Acliad/toast-o-meter/Board Files/Renders/Breadboard_DMM.png

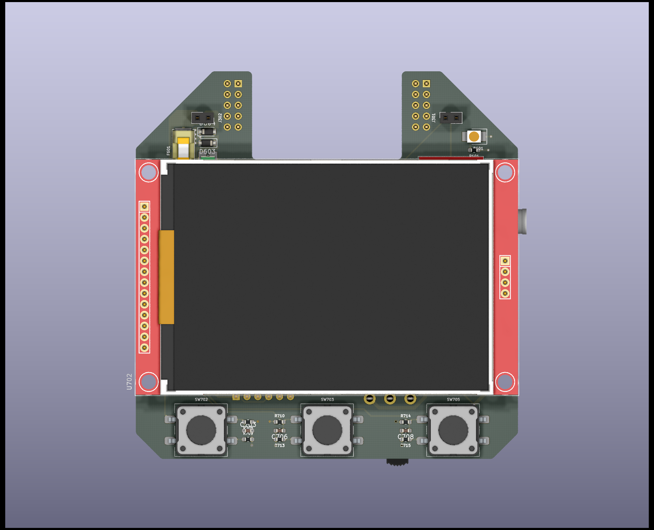
Board Files/Renders/Breadboard_DMM.png
