Acliad/toast-o-meter/Board Files/Graphics/Amps.png

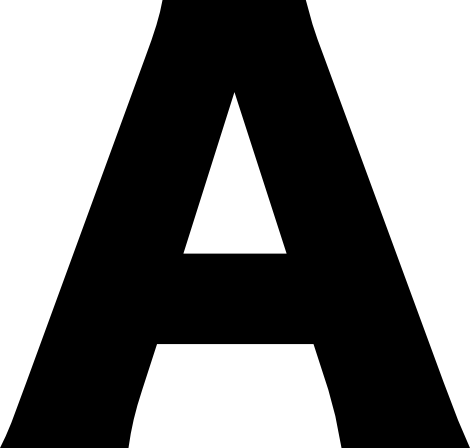
Board Files/Graphics/Amps.png
