Acliad/toast-o-meter/Board Files/Graphics/input_volts.png

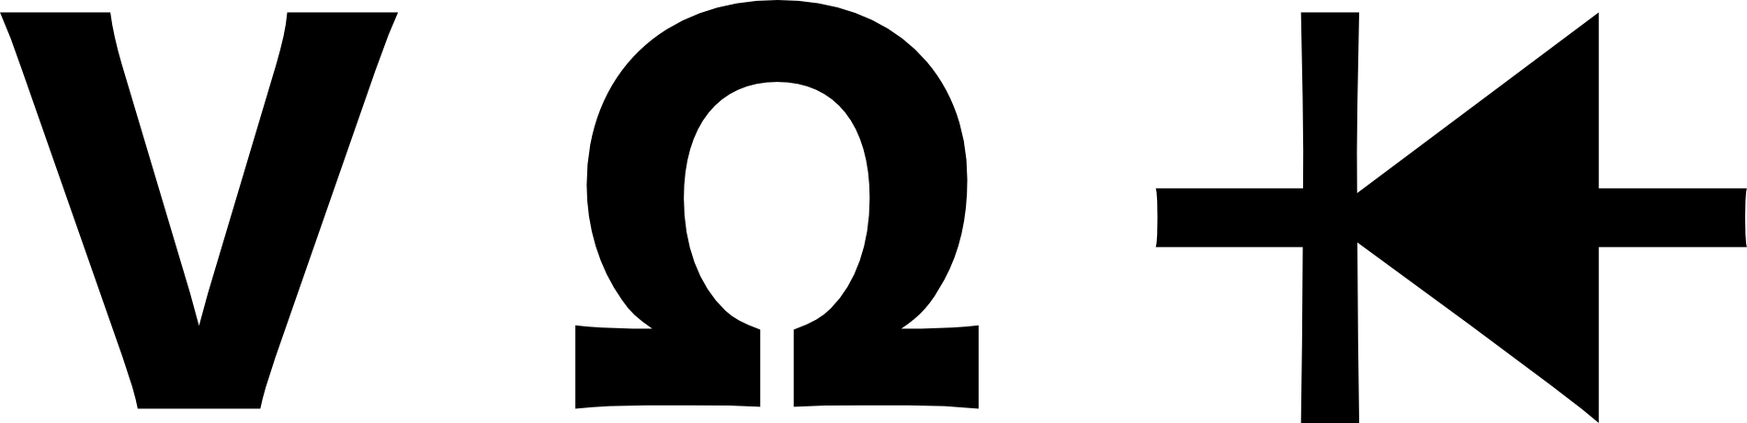
Board Files/Graphics/input_volts.png
