Acliad/toast-o-meter/Board Files/Graphics/ohms.png

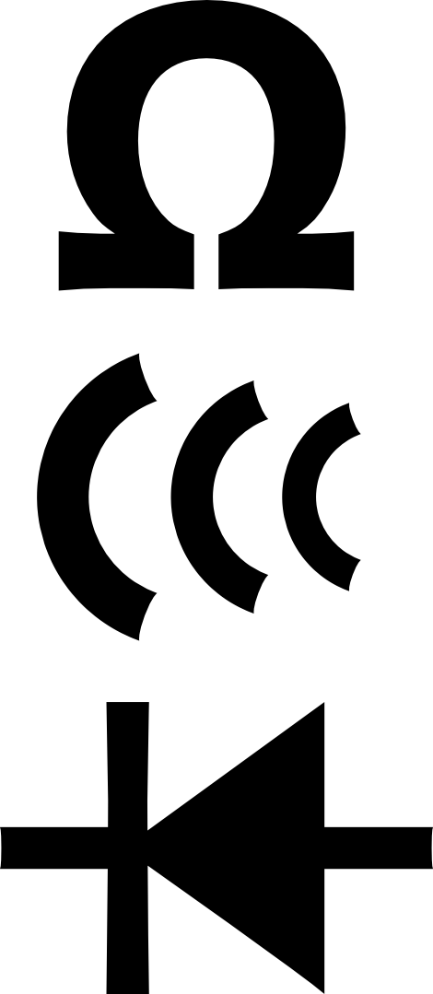
Board Files/Graphics/ohms.png
