Acliad/toast-o-meter/Board Files/Graphics/volts.png

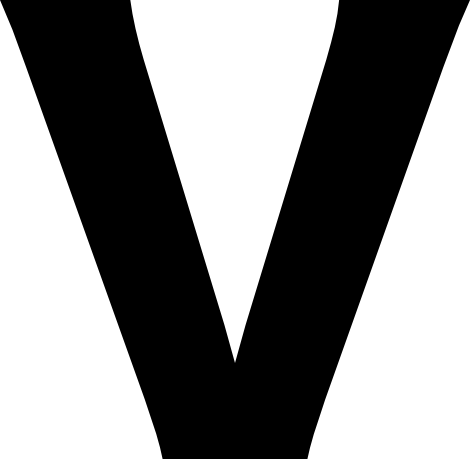
Board Files/Graphics/volts.png
