Acliad/toast-o-meter/Board Files/outline.dxf

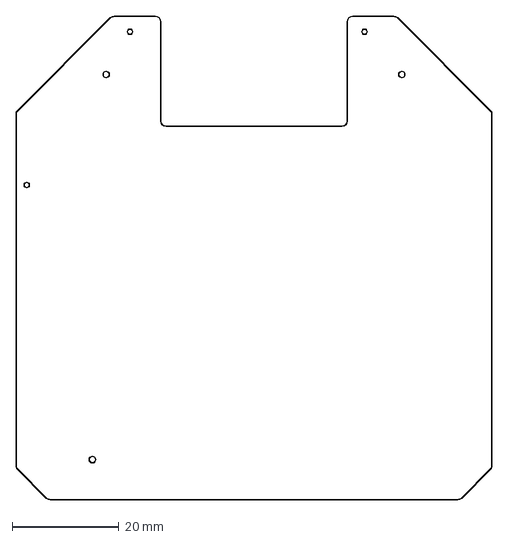
[picture p6: CAD file, 2020-11-14]
Board Files/outline.dxf
89.3 x 90.7 mm
