Acliad/toast-o-meter/Board Files/PDFs/Breadboard_DMM.pdf

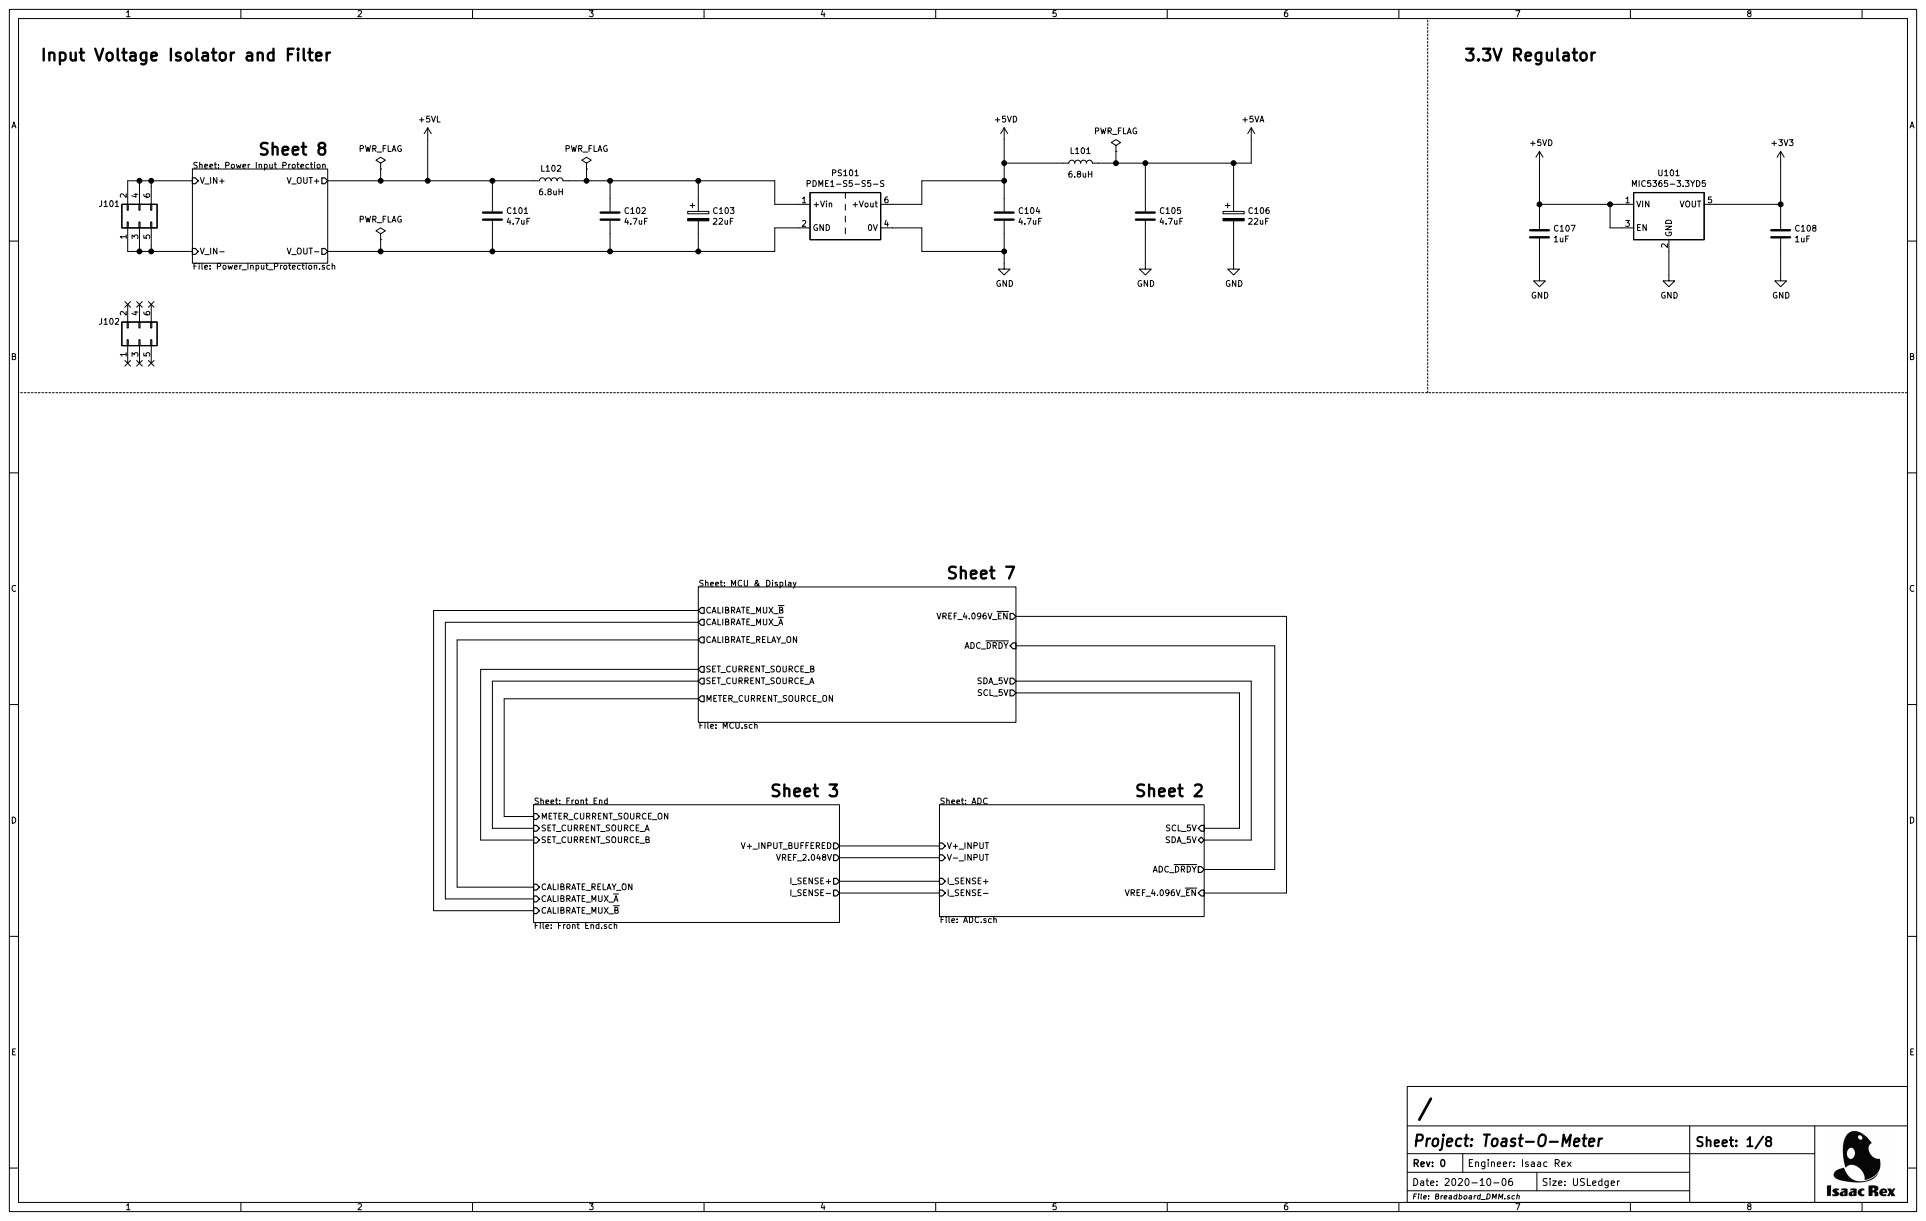
[picture p7: page 1]

Sheet: Power Input Protection

Sheet: MCU & Display File: MCU.sch CALIBRATE_RELAY_ON METER_CURRENT_SOURCE_ON

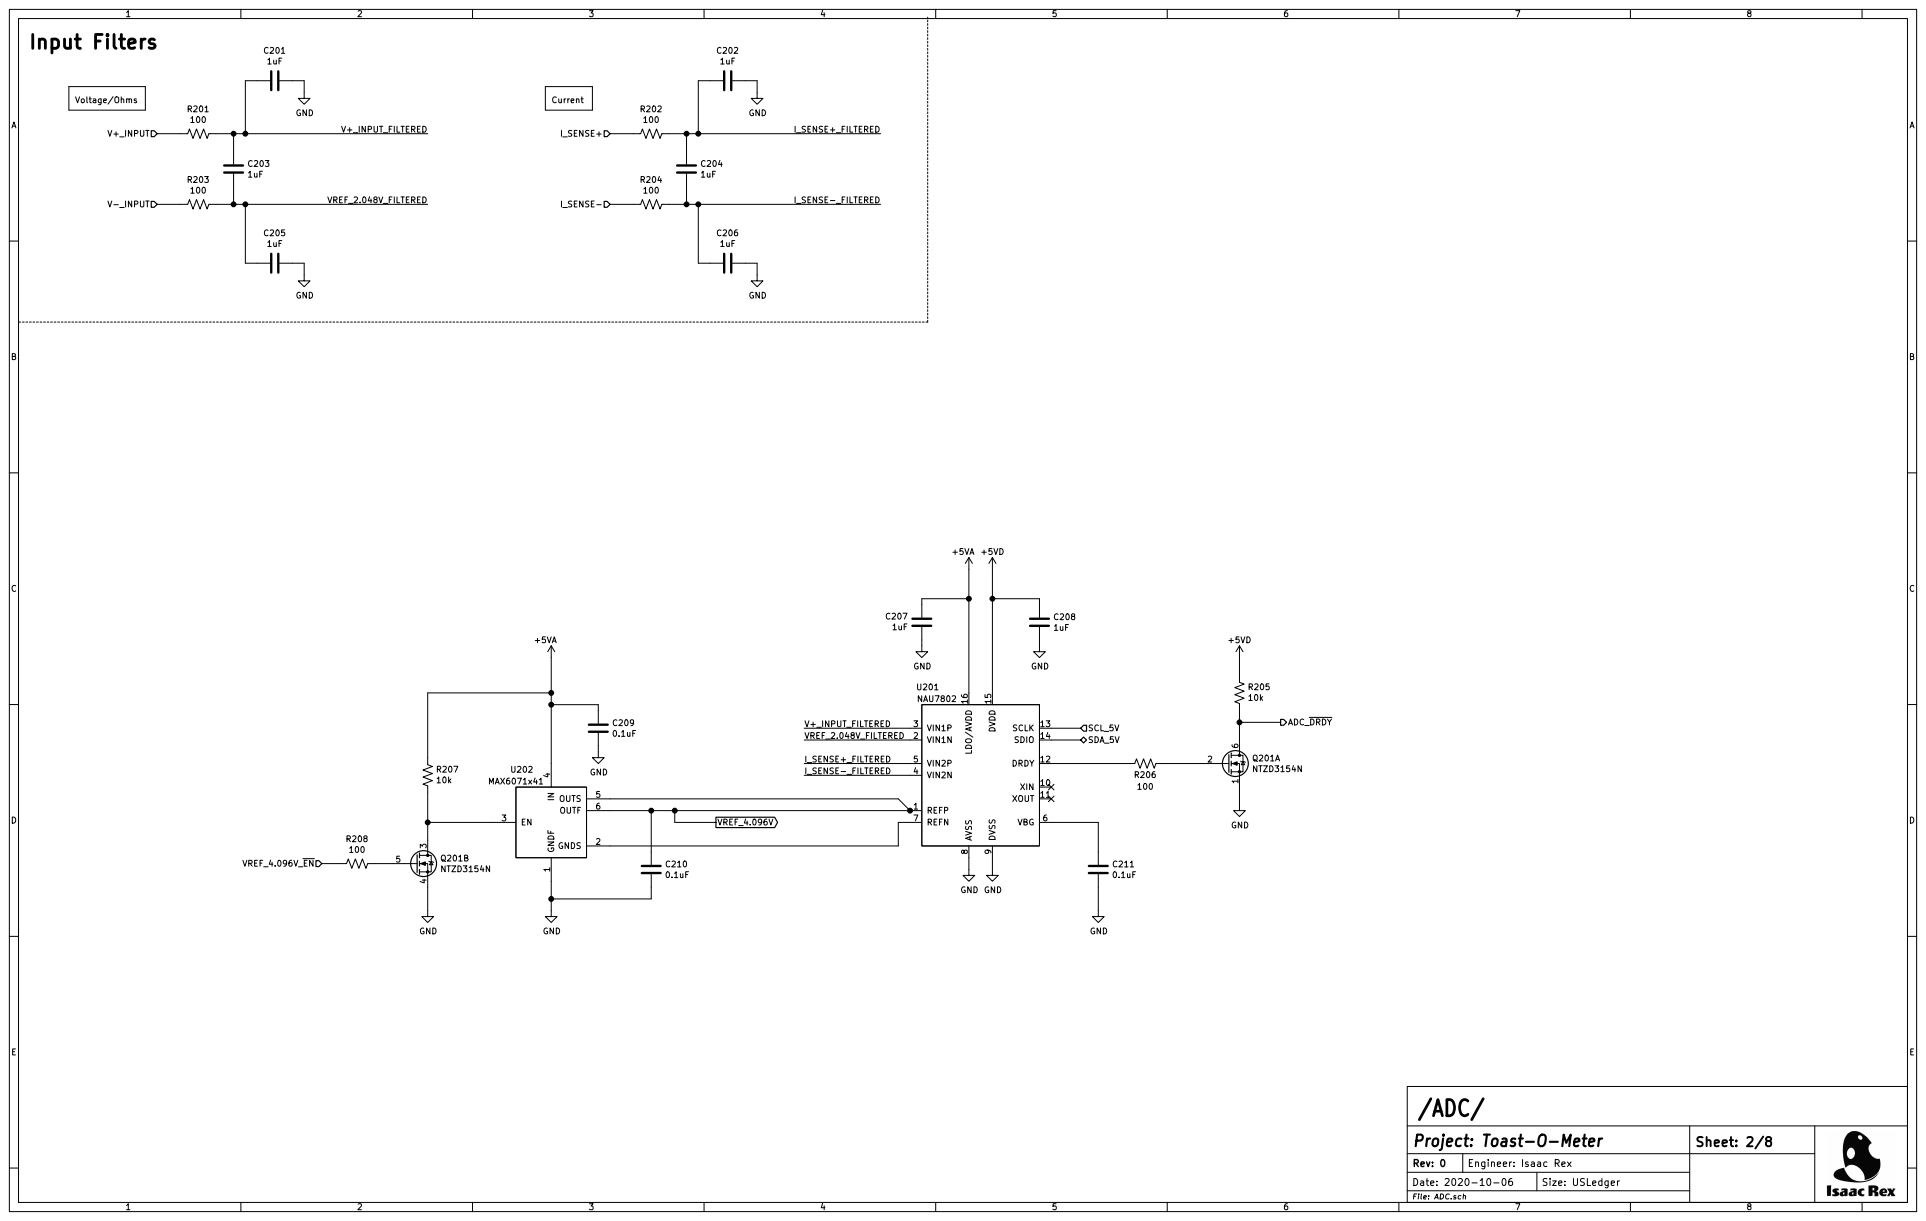
[picture p8: page 2]

File: ADC.sch /ADC/

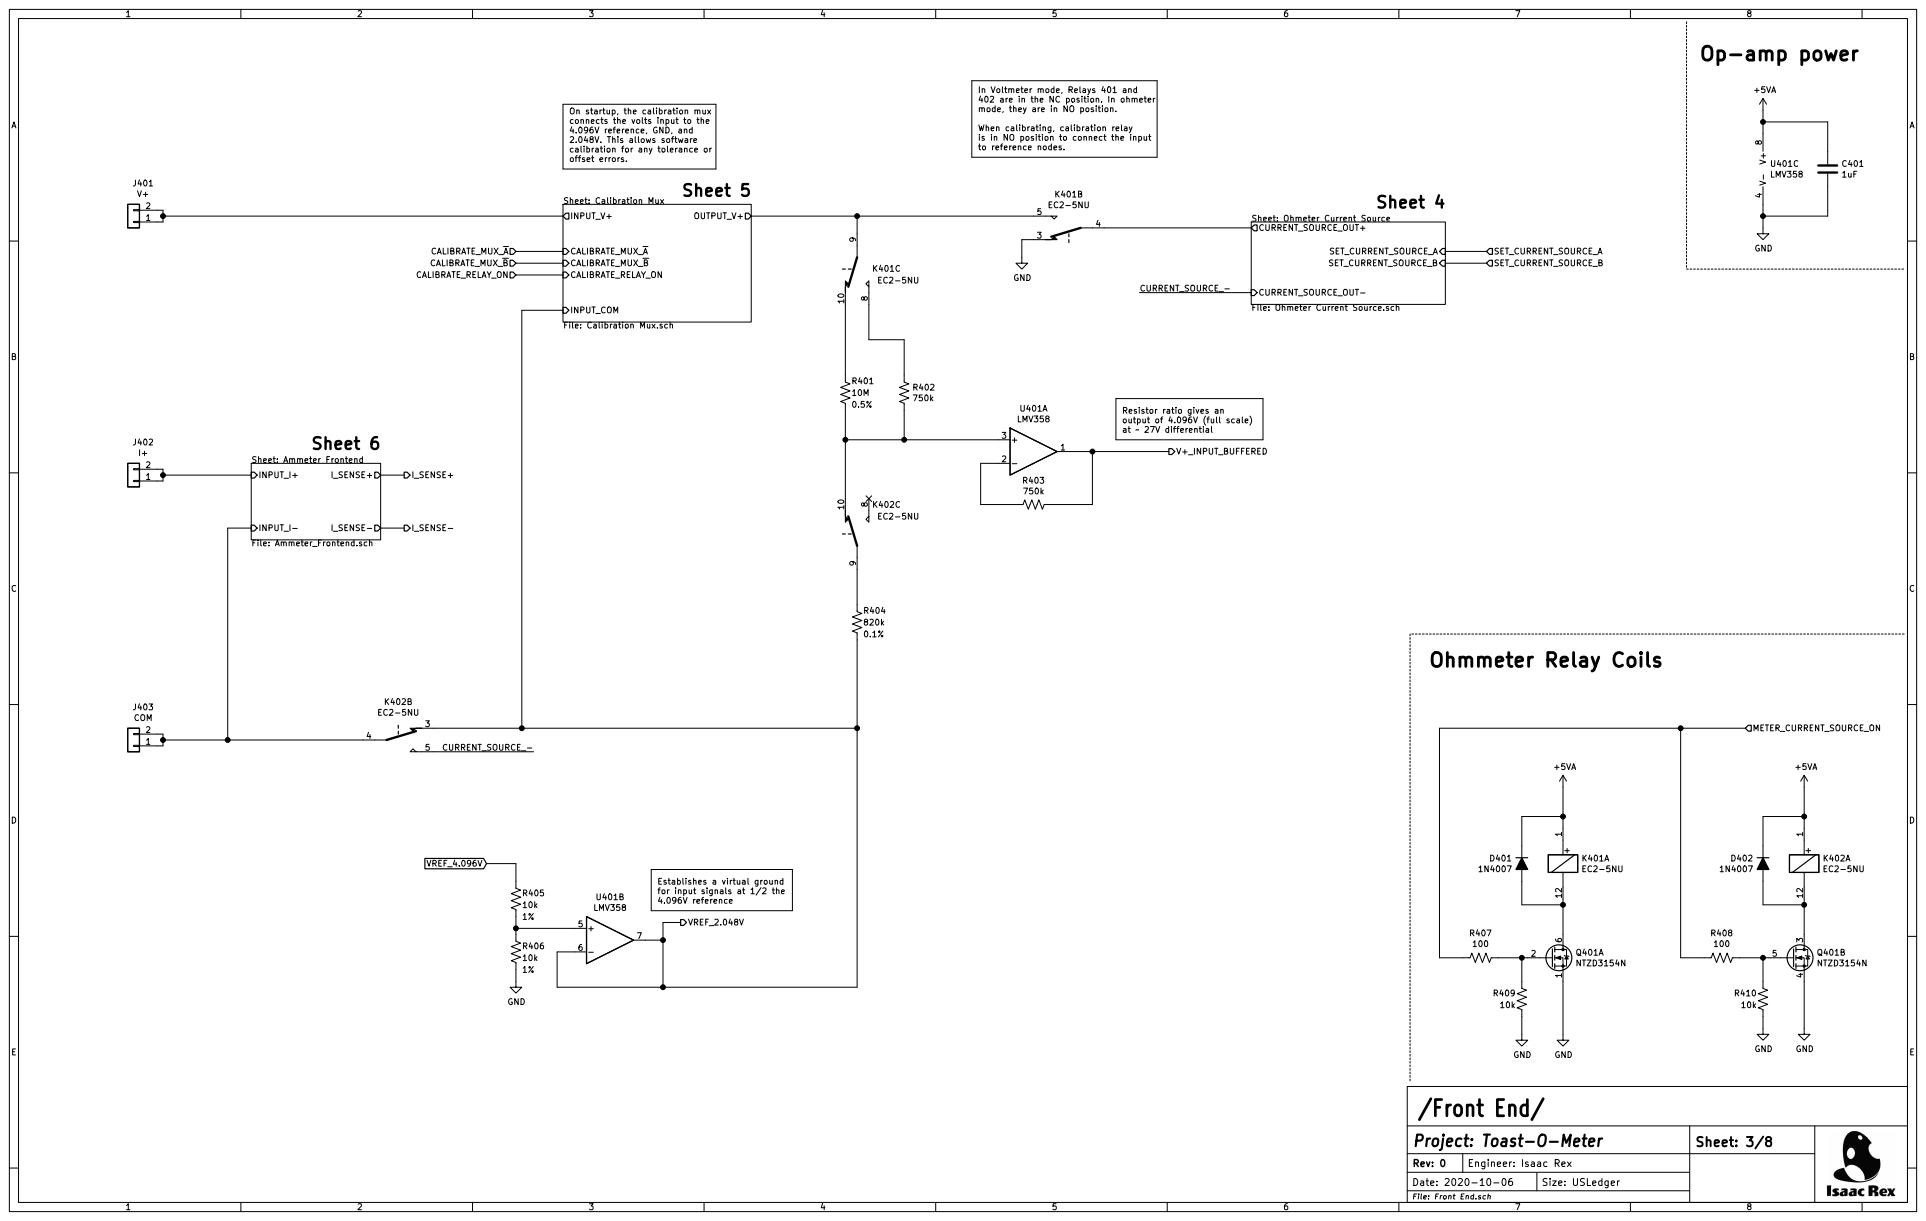
[picture p9: page 3]

In Voltmeter mode, Relays 401 and
402 are in the NC position. In ohmeter
mode, they are in NO position.

On startup, the calibration mux
connects the volts input to the
4.096V reference, GND, and 2.048V. This allows software calibration for any tolerance or offset errors.

When calibrating, calibration relay
is in NO position to connect the input

Sheet: Calibration Mux File: Calibration Mux.sch

SET_CURRENT_SOURCE_B CURRENT_SOURCE_OUT+ CURRENT_SOURCE_OUT- Sheet: Ammeter Frontend File: Ammeter_Frontend.sch

Resistor ratio gives an

File: Front End.sch /Front End/

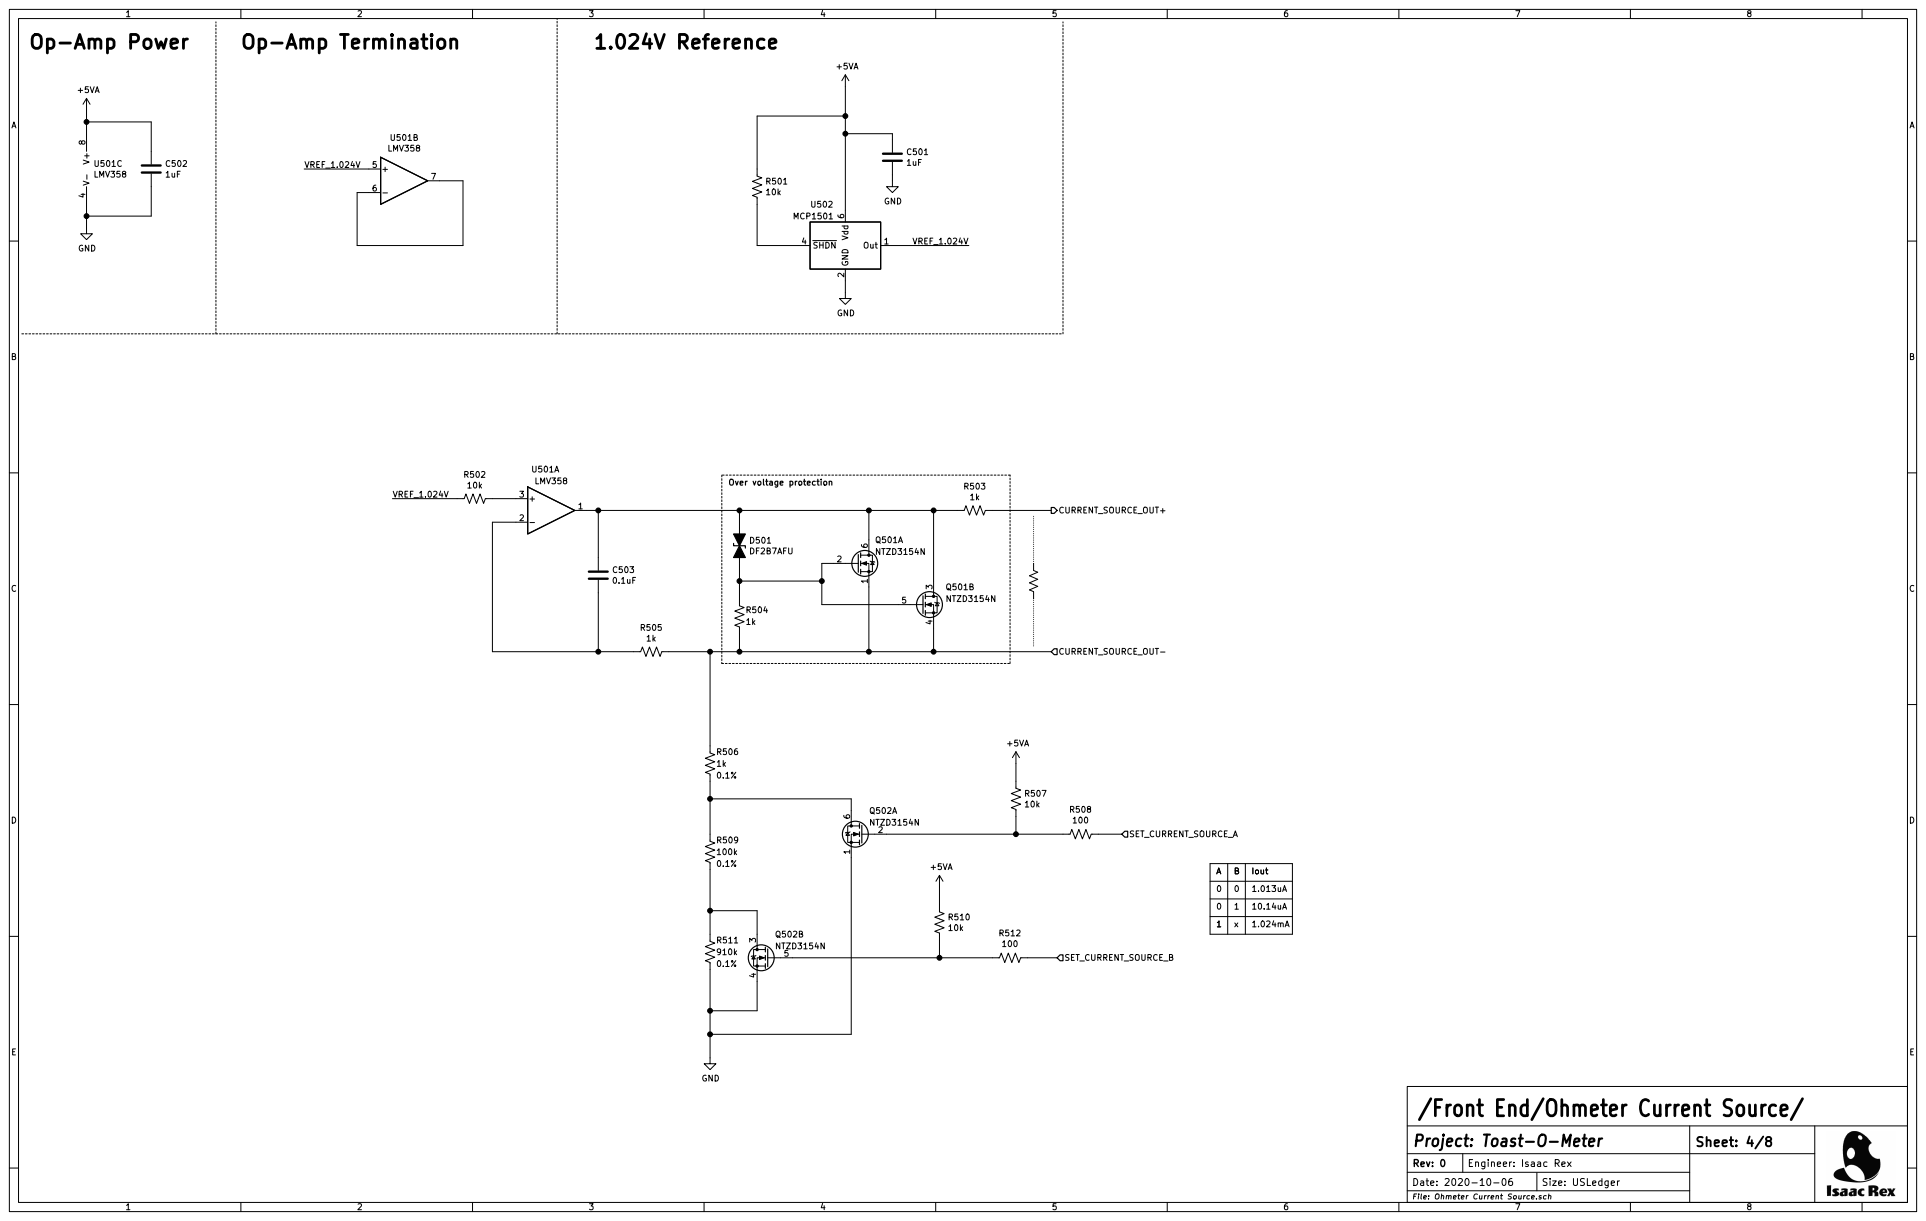
[picture p10: page 4]

1A | B 0 xB | Iout 0 Iout 1.013uA

File: Ohmeter Current Source.sch /Front End/Ohmeter Current Source/

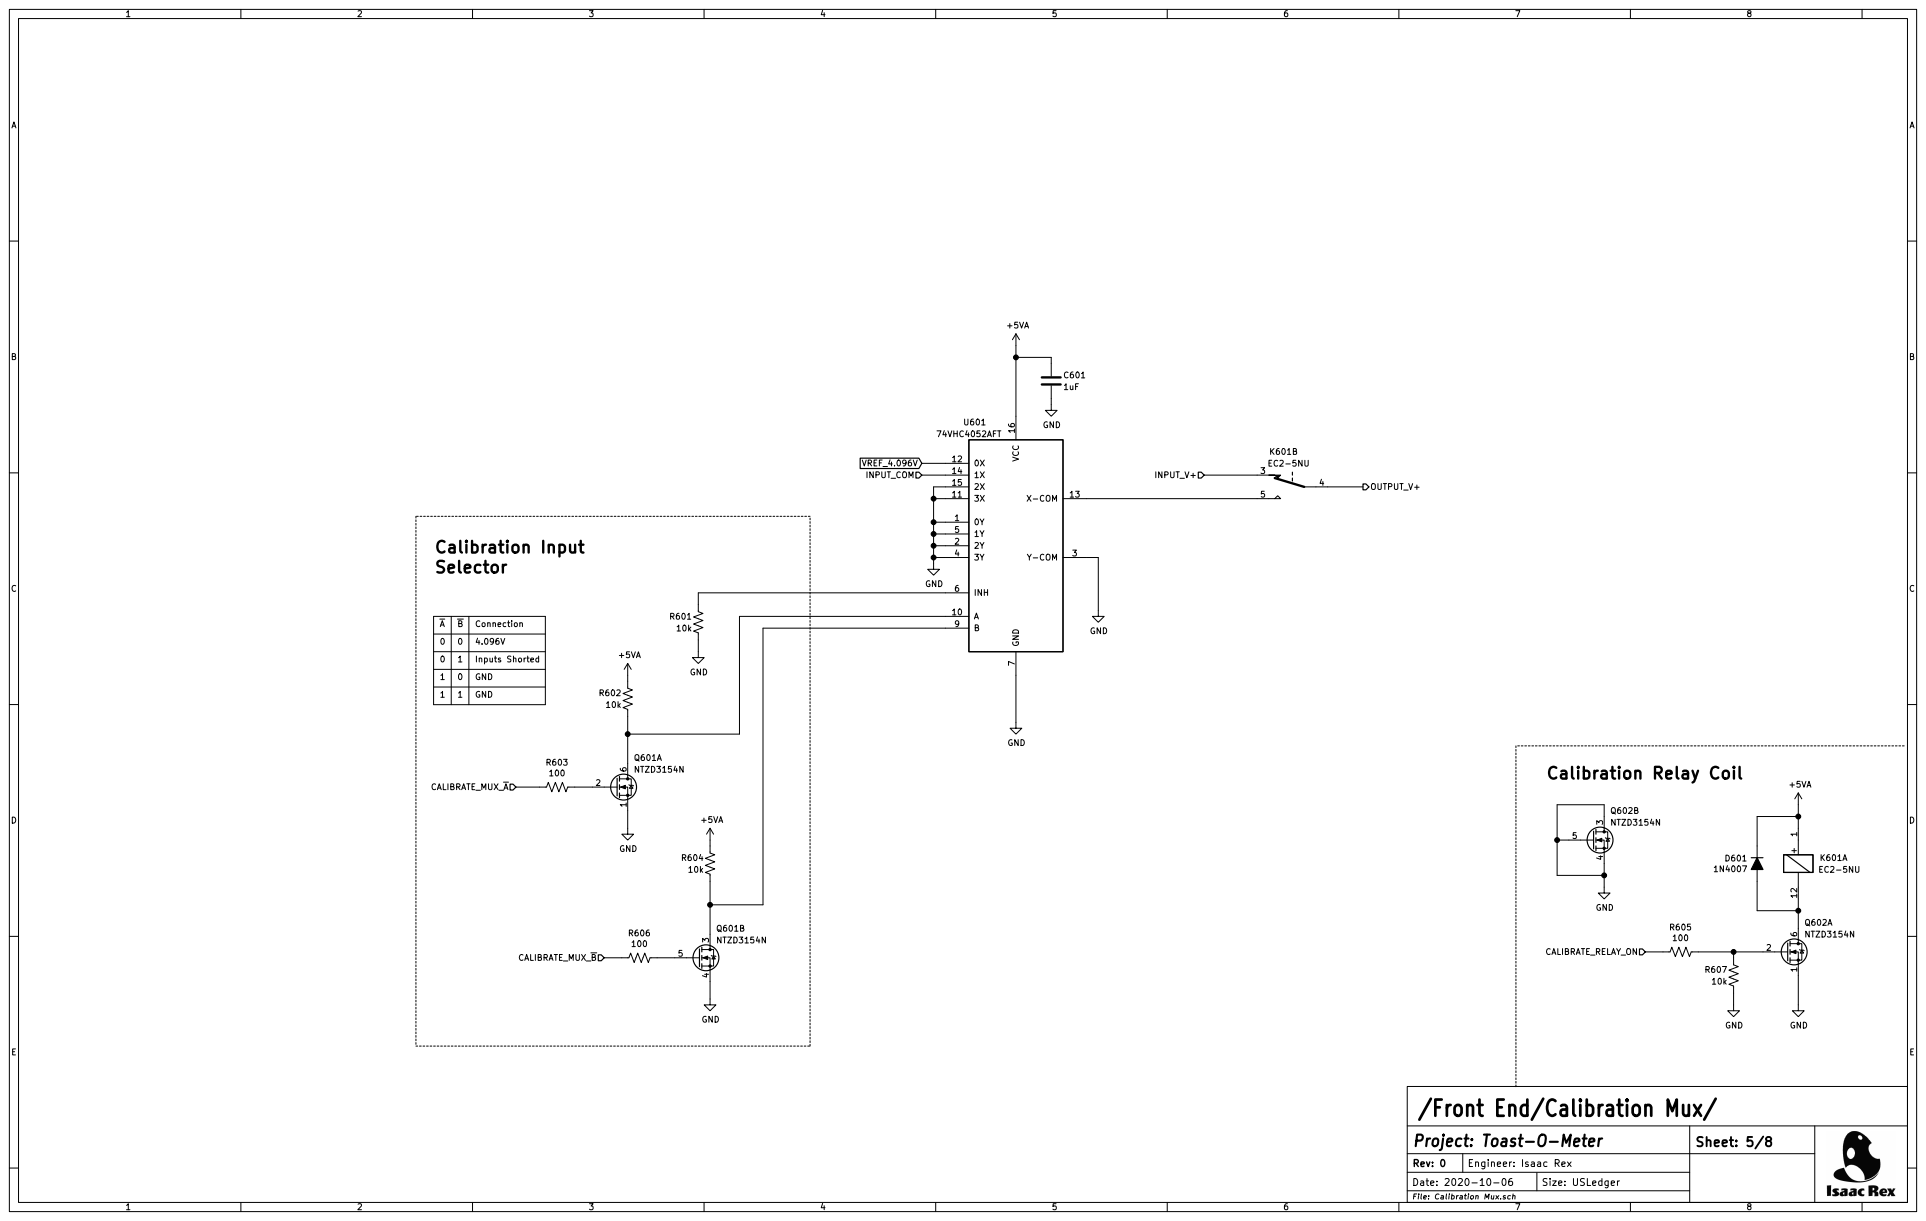
[picture p11: page 5]

0 A B 0 | 4.096V
0 0 | 1 | GND Inputs Shorted

1 | 1 | GND

Engineer: Isaac Rex GND

File: Calibration Mux.sch /Front End/Calibration Mux/

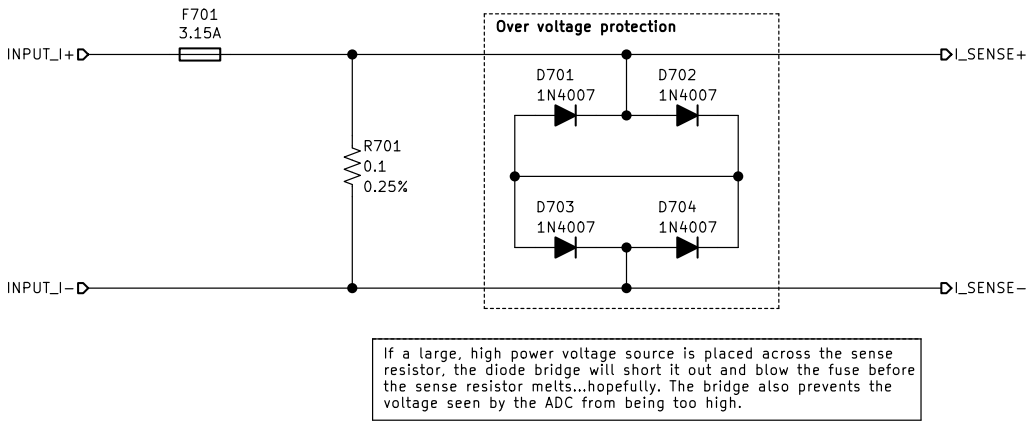
[picture p12: page 6]

If a large, high power voltage source is placed across the sense
resistor, the diode bridge will short it out and blow the fuse before
the sense resistor meltshopefully. The bridge also prevents the
voltage seen by the ADC from being too high.

File: Ammeter_Frontend.sch /Front End/Ammeter Frontend/

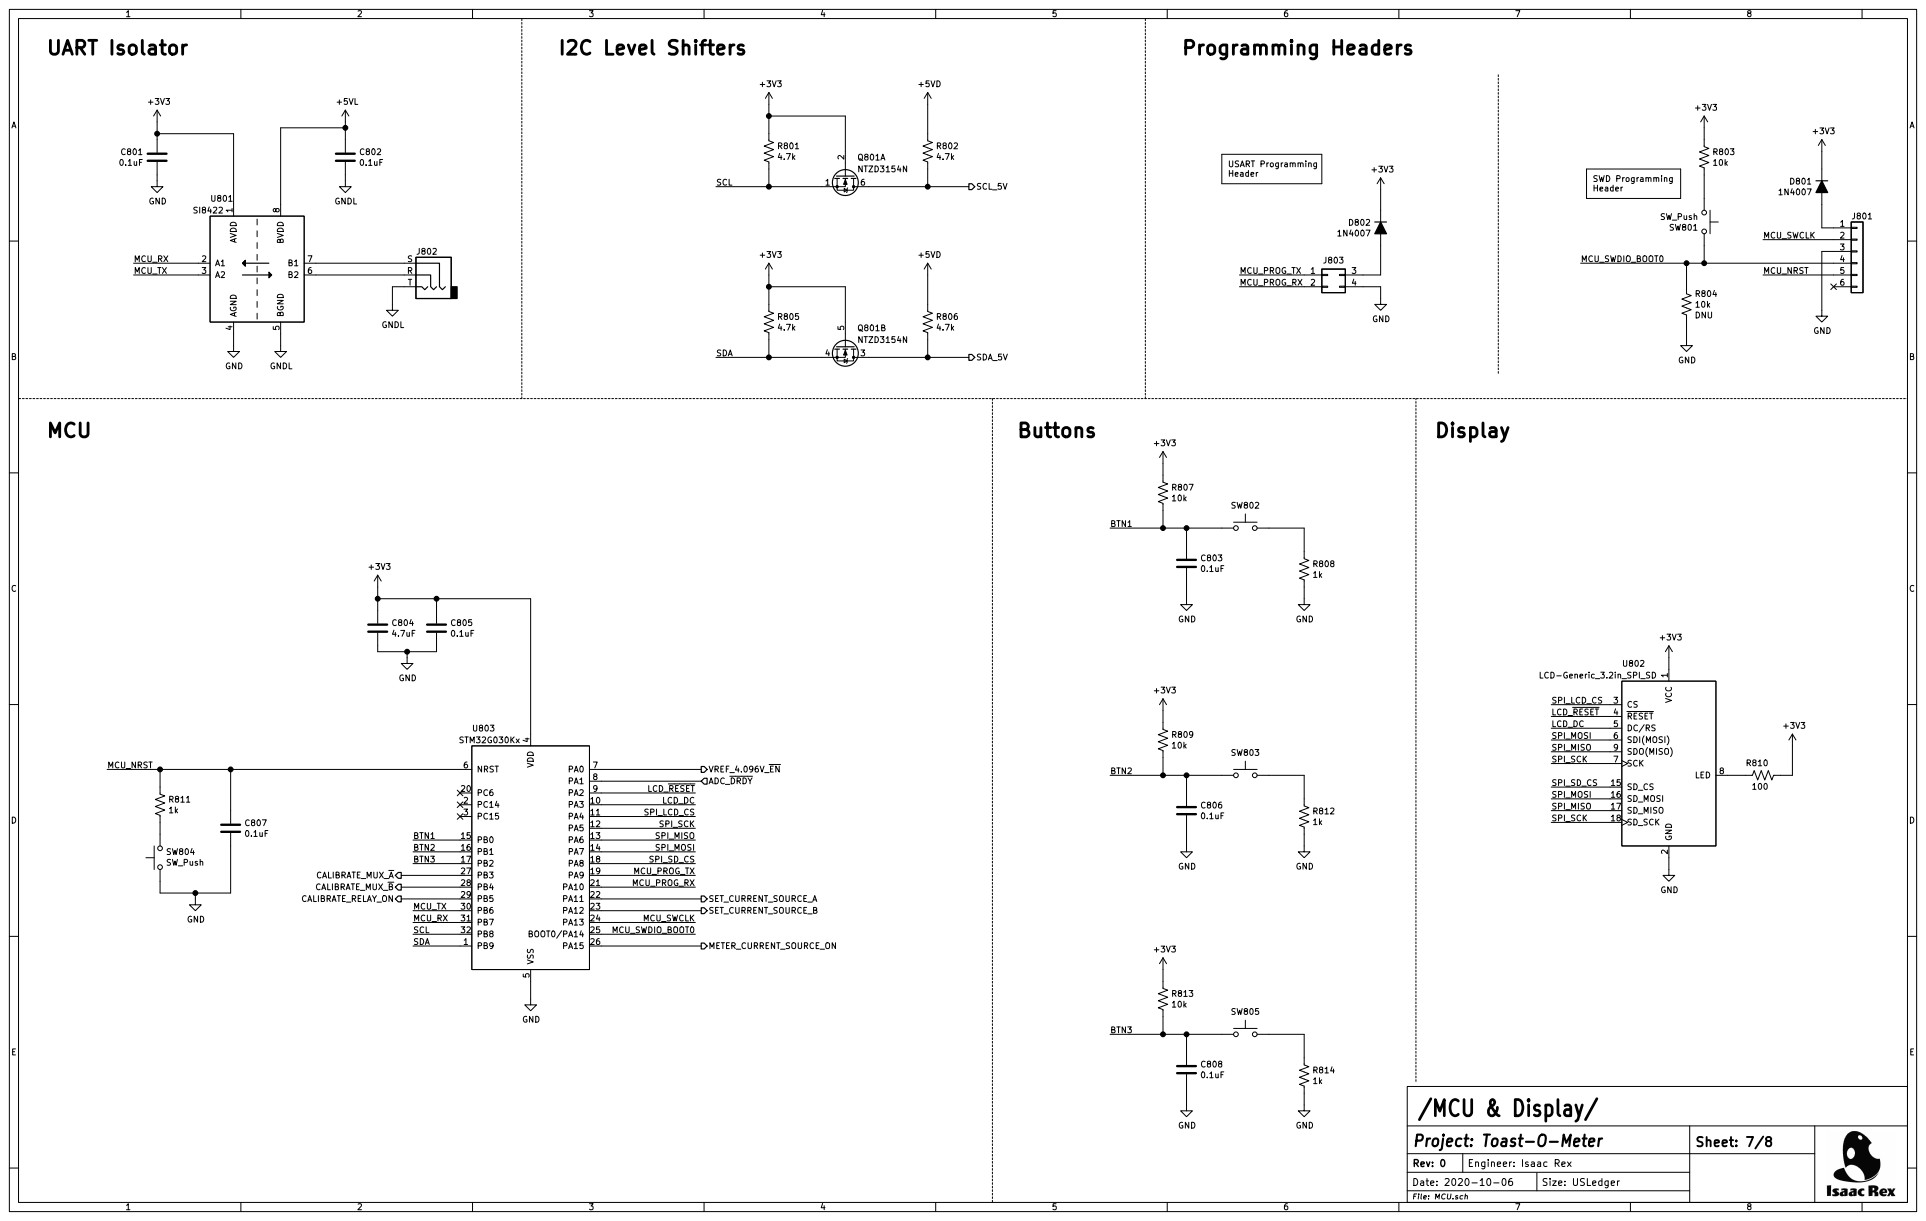
[picture p13: page 7]

File: MCU.sch /MCU & Display/

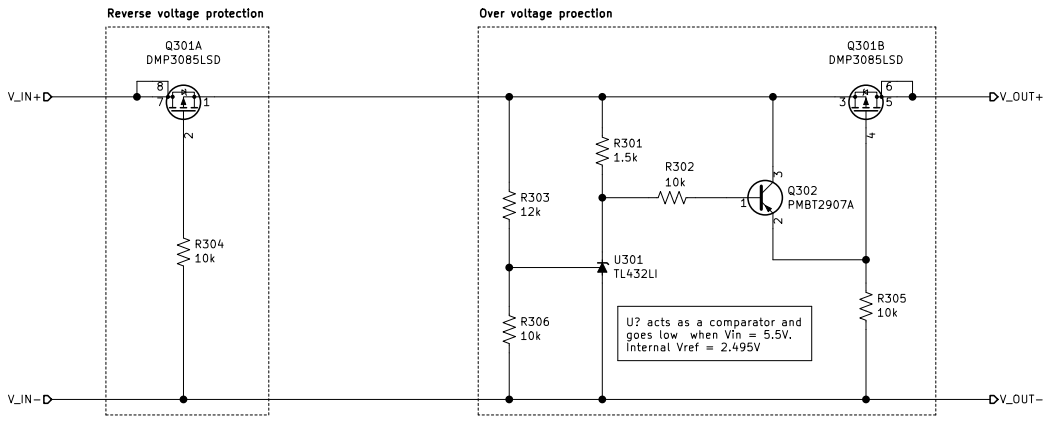
[picture p14: page 8]

Internal Vref = 2.495V Reverse voltage protection

U? acts as a comparator and
goes low when Vin = 5.5V.

File: Power_Input_Protection.sch /Power Input Protection/
