Acliad/toast-o-meter/Board Files/Breadboard_DMM/Breadboard_DMM.kicad_pcb

## KiCad design Board Files/Breadboard_DMM/Breadboard_DMM.kicad_pcb (2021-01-10)

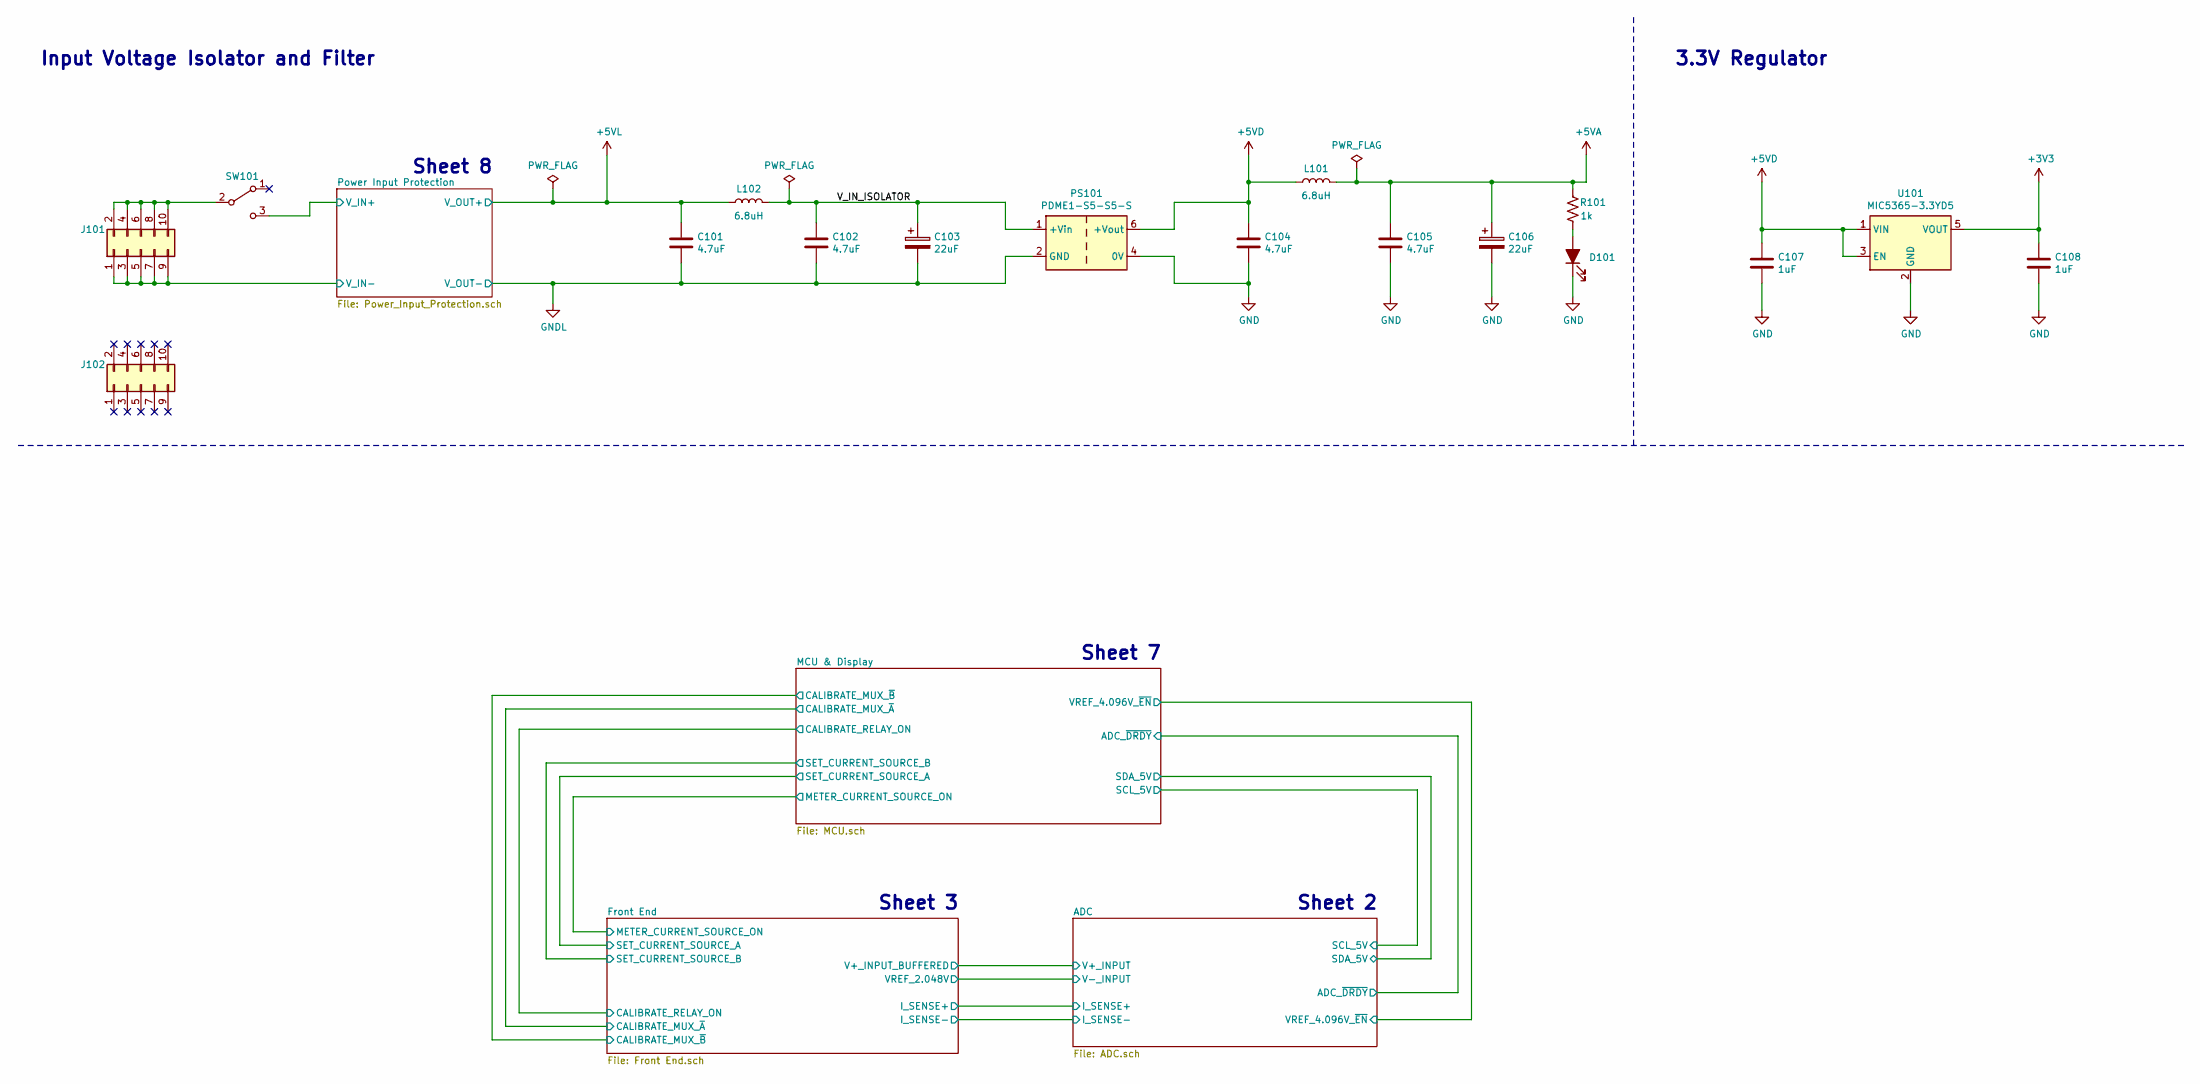
[picture p15: schematic Breadboard_DMM.sch, Toast-O-Meter]

Parts:
C101, C102, C104, C105: 4.7uF; C_0805_2012Metric_Pad1.18x1.45mm_HandSolder; Digi-Key PN 1276-6462-1-ND
C103, C106: 22uF; CP_Elec_5x5.3; Digi-Key PN 732-8505-1-ND
C107, C108: 1uF; C_0603_1608Metric_Pad1.08x0.95mm_HandSolder; Digi-Key PN 1276-6524-1-ND
D101: Pink; LED_Kingbright_AA3528V_3.5x2.8mm_handsolder; MPN AA3528VRVCS/A; Digi-Key PN 754-1534-1-ND
J101, J102: Conn_02x05_Odd_Even; PinHeader_2x05_P2.54mm_Vertical; Digi-Key PN 2057-PH2-10-UA-ND
L101, L102: 6.8uH; L_Taiyo-Yuden_NR-30xx_HandSoldering; Digi-Key PN 587-2592-1-ND
PS101: PDME1-S5-S5-S; CUI_DCDC-CONVERTER_PDME1-Sxx-S_1x4_P2.54mm_Drill1.0mm; MPN PDME1-S5-S5-S; Digi-Key PN 102-6320-ND
R101: 1k; R_0603_1608Metric_Pad1.05x0.95mm_HandSolder; Digi-Key PN 311-1.00KHRCT-ND
SW101: L102021ML04Q; SW_CuK_L102021ML04Q_SPDT_Angled; MPN L102021ML04Q; Digi-Key PN CKC5102-ND
U101: MIC5365-3.3YD5; SOT-23-5; Digi-Key PN 576-4085-1-ND

Connections:
+3V3: C108.1, U101.5 (VOUT); also elsewhere on the board
+5VA: C105.1, C106.1, L101.2, R101.1; also elsewhere on the board
+5VD: C104.1, C107.1, L101.1, PS101.6 (+Vout), U101.1 (VIN), U101.3 (EN); also elsewhere on the board
+5VL: C101.1, L102.1; also elsewhere on the board
/Power Input Protection/V_IN+: SW101.3 (C); also elsewhere on the board
/V_IN_ISOLATOR: C102.1, C103.1, L102.2, PS101.1 (+Vin)
GND: C104.2, C105.2, C106.2, C107.2, C108.2, D101.1 (K), PS101.4 (0V), U101.2 (GND); also elsewhere on the board
GNDL: C101.2, C102.2, C103.2, J101.1, J101.3, J101.5, J101.7, J101.9, PS101.2 (GND); also elsewhere on the board
unnamed: D101.2 (A), R101.2
unnamed: J101.2, J101.4, J101.6, J101.8, J101.10, SW101.2 (B)

Notes on the sheet:
Input Voltage Isolator and Filter
3.3V Regulator
Sheet 7
Sheet 2
Sheet 8
Sheet 3

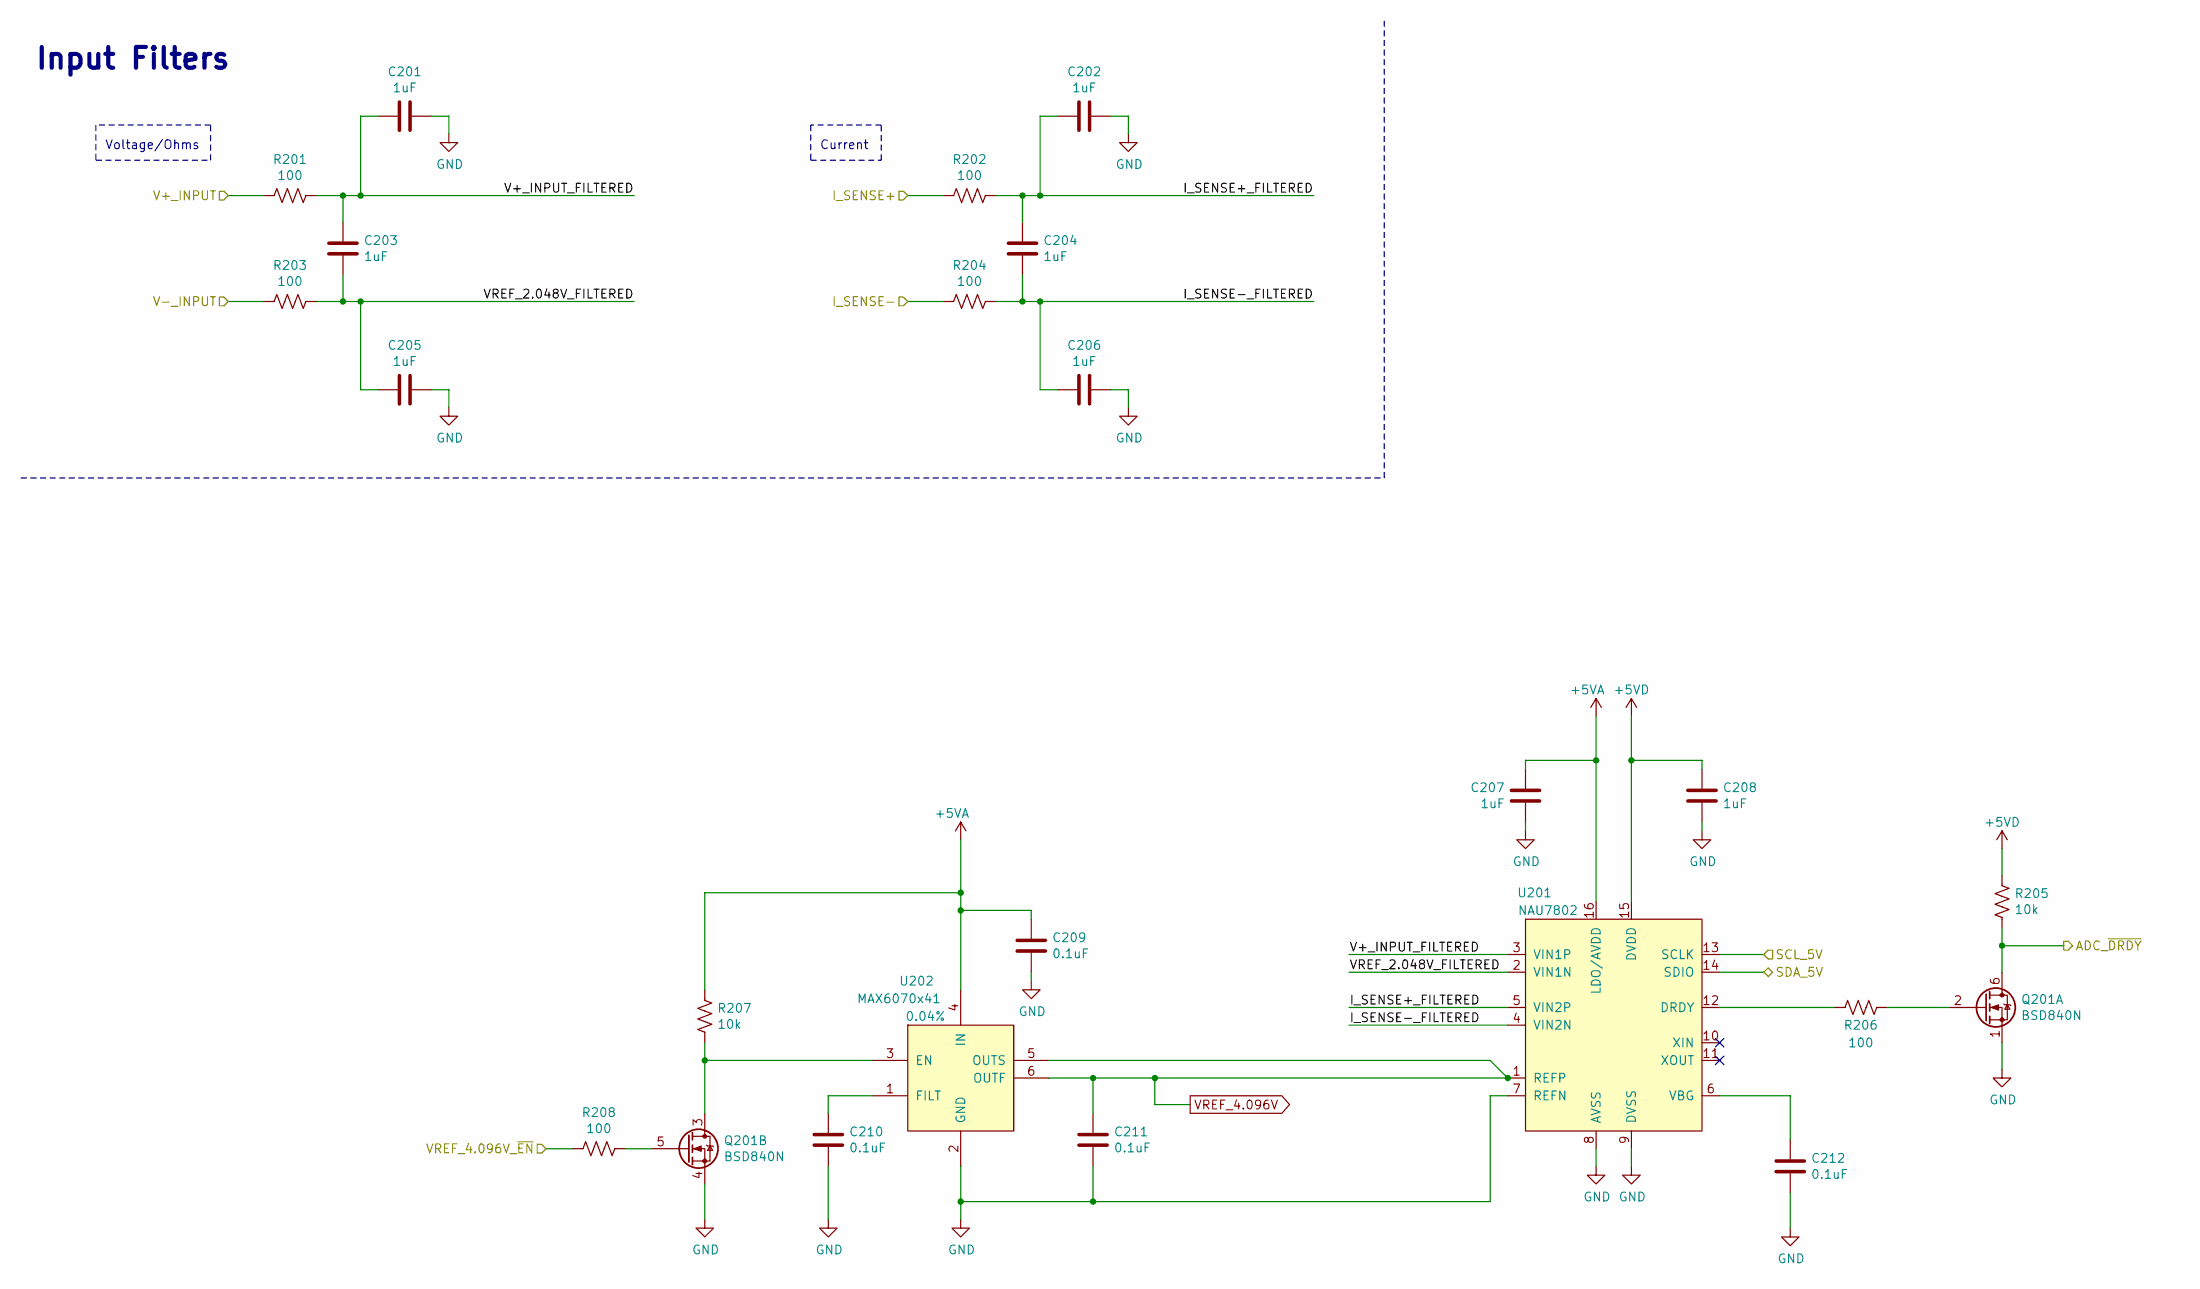
[picture p16: schematic ADC.sch, Toast-O-Meter]

Parts:
C201, C202, C203, C204, C205, C206, C207, C208: 1uF; C_0603_1608Metric_Pad1.08x0.95mm_HandSolder; Digi-Key PN 1276-6524-1-ND
C209, C210, C211, C212: 0.1uF; C_0603_1608Metric_Pad1.08x0.95mm_HandSolder; Digi-Key PN 1276-1006-1-ND
Q201: BSD840N; SOT-363_SC-70-6_Handsoldering; MPN BSD840NH6327XTSA1; Digi-Key PN BSD840NH6327XTSA1CT-ND
R201, R202, R203, R204, R206, R208: 100; R_0603_1608Metric_Pad1.05x0.95mm_HandSolder; Digi-Key PN 311-100HRCT-ND
R205, R207: 10k; R_0603_1608Metric_Pad1.05x0.95mm_HandSolder; Digi-Key PN 311-10.0KHRCT-ND
U201: NAU7802; SOP-16_4.55x10.3mm_P1.27mm; MPN NAU7802; Digi-Key PN NAU7802SGI-ND
U202: MAX6070x41; SOT-23-6; Tolerance 0.04%; Digi-Key PN MAX6070AAUT41+TCT-ND

Connections:
+5VA: C207.2, C209.1, R207.2, U201.16 (LDO/AVDD), U202.4 (IN); also elsewhere on the board
+5VD: C208.1, R205.2, U201.15 (DVDD); also elsewhere on the board
/ADC/ADC_~DRDY: Q201.6 (D1), R205.1; also elsewhere on the board
/ADC/I_SENSE+: R202.1; also elsewhere on the board
/ADC/I_SENSE+_FILTERED: C202.1, C204.1, R202.2, U201.5 (VIN2P)
/ADC/I_SENSE-: R204.1; also elsewhere on the board
/ADC/I_SENSE-_FILTERED: C204.2, C206.1, R204.2, U201.4 (VIN2N)
/ADC/SCL_5V: U201.13 (SCLK); also elsewhere on the board
/ADC/SDA_5V: U201.14 (SDIO); also elsewhere on the board
/ADC/V+_INPUT: R201.1; also elsewhere on the board
/ADC/V+_INPUT_FILTERED: C201.1, C203.1, R201.2, U201.3 (VIN1P)
/ADC/V-_INPUT: R203.1; also elsewhere on the board
/ADC/VREF_2.048V_FILTERED: C203.2, C205.1, R203.2, U201.2 (VIN1N)
/ADC/VREF_4.096V_~EN: R208.1; also elsewhere on the board
GND: C201.2, C202.2, C205.2, C206.2, C207.1, C208.2, C209.2, C210.2, C211.2, C212.2, Q201.1 (S1), Q201.4 (S2), U201.7 (REFN), U201.8 (AVSS), U201.9 (DVSS), U202.2 (GND); also elsewhere on the board
unnamed: C210.1, U202.1 (FILT)
unnamed: C212.1, U201.6 (VBG)
unnamed: Q201.2 (G1), R206.2
unnamed: Q201.3 (D2), R207.1, U202.3 (EN)
unnamed: Q201.5 (G2), R208.2
unnamed: R206.1, U201.12 (DRDY)
VREF_4.096V: C211.1, U201.1 (REFP), U202.5 (OUTS), U202.6 (OUTF); also elsewhere on the board

Notes on the sheet:
Input Filters
Current
Voltage/Ohms

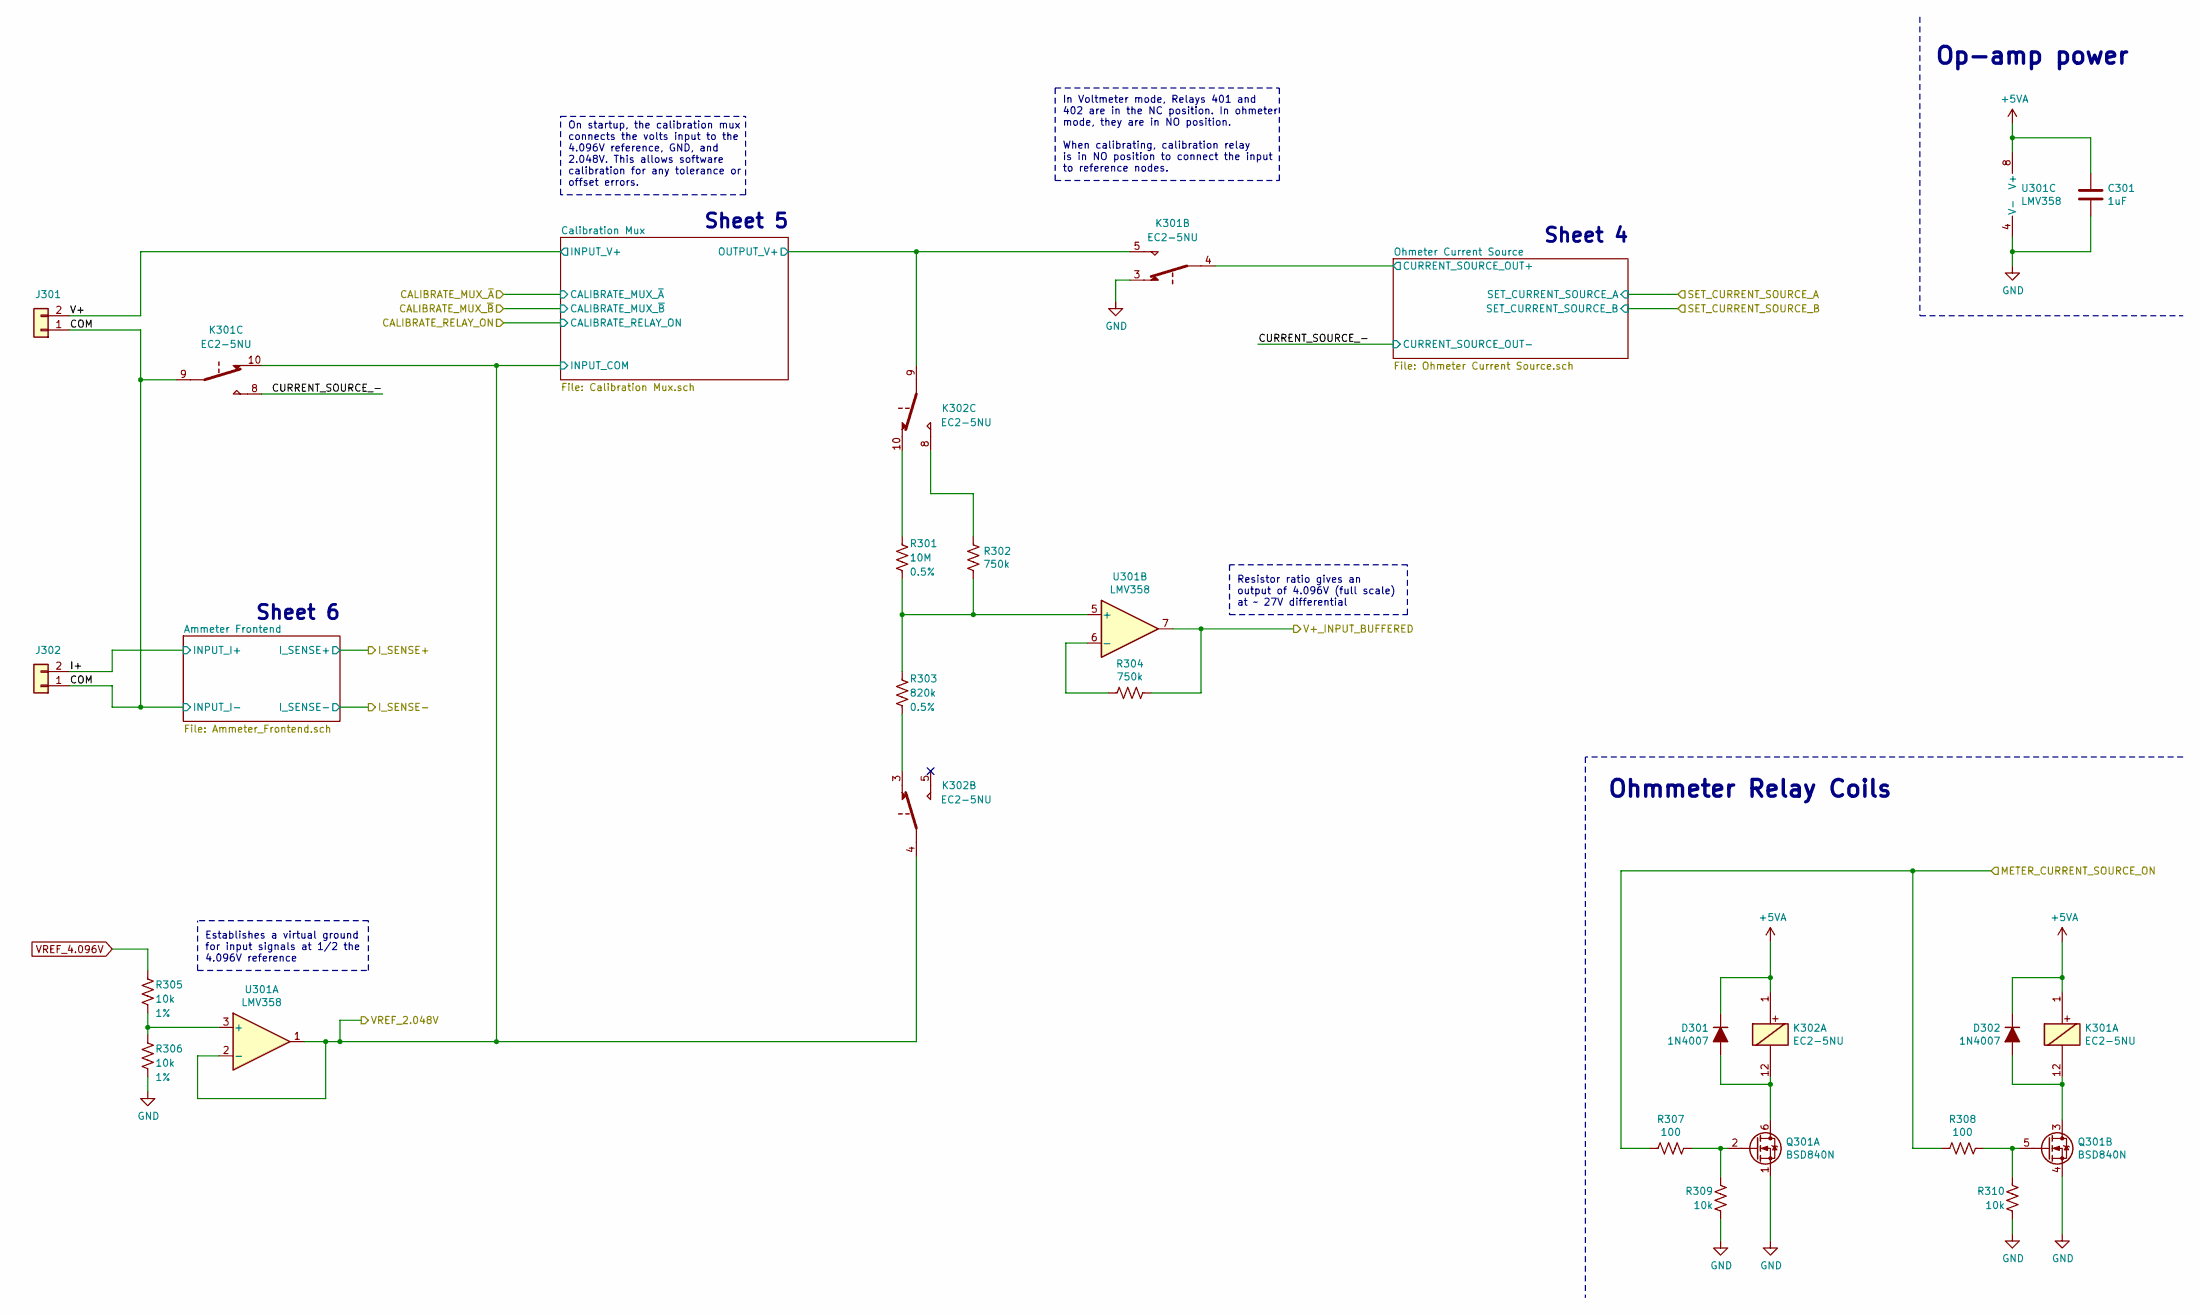
[picture p17: schematic Front End.sch, Toast-O-Meter]

Parts:
C301: 1uF; C_0603_1608Metric_Pad1.08x0.95mm_HandSolder; Digi-Key PN 1276-6524-1-ND
D301, D302: 1N4007; D_SOD-123; Digi-Key PN 1655-1N4007FLCT-ND
J301, J302: Conn_01x02; PinSocket_1x02_P2.54mm_Vertical; Digi-Key PN SAM1213-02-ND
K301, K302: EC2-5NU; Relay_DPDT_Kemet_EC2; MPN EC2-5NU; Digi-Key PN 399-11052-5-ND
Q301: BSD840N; SOT-363_SC-70-6_Handsoldering; MPN BSD840NH6327XTSA1; Digi-Key PN BSD840NH6327XTSA1CT-ND
R301: 10M; R_0603_1608Metric_Pad1.05x0.95mm_HandSolder; Tolerance 0.5%; Digi-Key PN 541-10MAYCT-ND
R302, R304: 750k; R_0603_1608Metric_Pad1.05x0.95mm_HandSolder; Digi-Key PN 311-750KHRCT-ND
R303: 820k; R_0805_2012Metric_Pad1.15x1.40mm_HandSolder; Tolerance 0.5%; Digi-Key PN RR12P820KDCT-ND
R305, R306: 10k; R_0603_1608Metric_Pad1.05x0.95mm_HandSolder; Tolerance 1%; Digi-Key PN 311-10.0KHRCT-ND
R307, R308: 100; R_0603_1608Metric_Pad1.05x0.95mm_HandSolder; Digi-Key PN 311-100HRCT-ND
R309, R310: 10k; R_0603_1608Metric_Pad1.05x0.95mm_HandSolder; Digi-Key PN 311-10.0KHRCT-ND
U301: LMV358; SOIC-8_3.9x4.9mm_P1.27mm; Digi-Key PN 296-47593-1-ND

Connections:
+5VA: C301.1, D301.1 (K), D302.1 (K), K301.1, K302.1, U301.8 (V+); also elsewhere on the board
/ADC/I_SENSE-: J301.1, J302.1, K301.9; also elsewhere on the board
/ADC/V+_INPUT: R304.1, U301.7; also elsewhere on the board
/ADC/V-_INPUT: K301.10, K302.4, U301.1, U301.2 (-); also elsewhere on the board
/Front End/CURRENT_SOURCE_-: K301.8; also elsewhere on the board
/Front End/Calibration Mux/OUTPUT_V+: K301.5, K302.9; also elsewhere on the board
/Front End/I+: J302.2; also elsewhere on the board
/Front End/METER_CURRENT_SOURCE_ON: R307.1, R308.1; also elsewhere on the board
/Front End/Ohmeter Current Source/CURRENT_SOURCE_OUT+: K301.4; also elsewhere on the board
/Front End/V+: J301.2; also elsewhere on the board
GND: C301.2, K301.3, Q301.1 (S1), Q301.4 (S2), R306.2, R309.2, R310.2, U301.4 (V-); also elsewhere on the board
unnamed: D301.2 (A), K302.12, Q301.6 (D1)
unnamed: D302.2 (A), K301.12, Q301.3 (D2)
unnamed: K302.3, R303.2
unnamed: K302.8, R302.1
unnamed: K302.10, R301.1
unnamed: Q301.2 (G1), R307.2, R309.1
unnamed: Q301.5 (G2), R308.2, R310.1
unnamed: R301.2, R302.2, R303.1, U301.5 (+)
unnamed: R304.2, U301.6 (-)
unnamed: R305.2, R306.1, U301.3 (+)
VREF_4.096V: R305.1; also elsewhere on the board

Notes on the sheet:
Resistor ratio gives an output of 4.096V (full scale) at ~~ 27V differential
In Voltmeter mode, Relays 401 and 402 are in the NC position. In ohmeter mode, they are in NO position. When calibrating, calibration relay is in NO position to connect the input to reference nodes.
On startup, the calibration mux connects the volts input to the 4.096V reference, GND, and 2.048V. This allows software calibration for any tolerance or offset errors.
Ohmmeter Relay Coils
Op-amp power
Sheet 6
Sheet 5
Sheet 4
Establishes a virtual ground for input signals at 1/2 the 4.096V reference

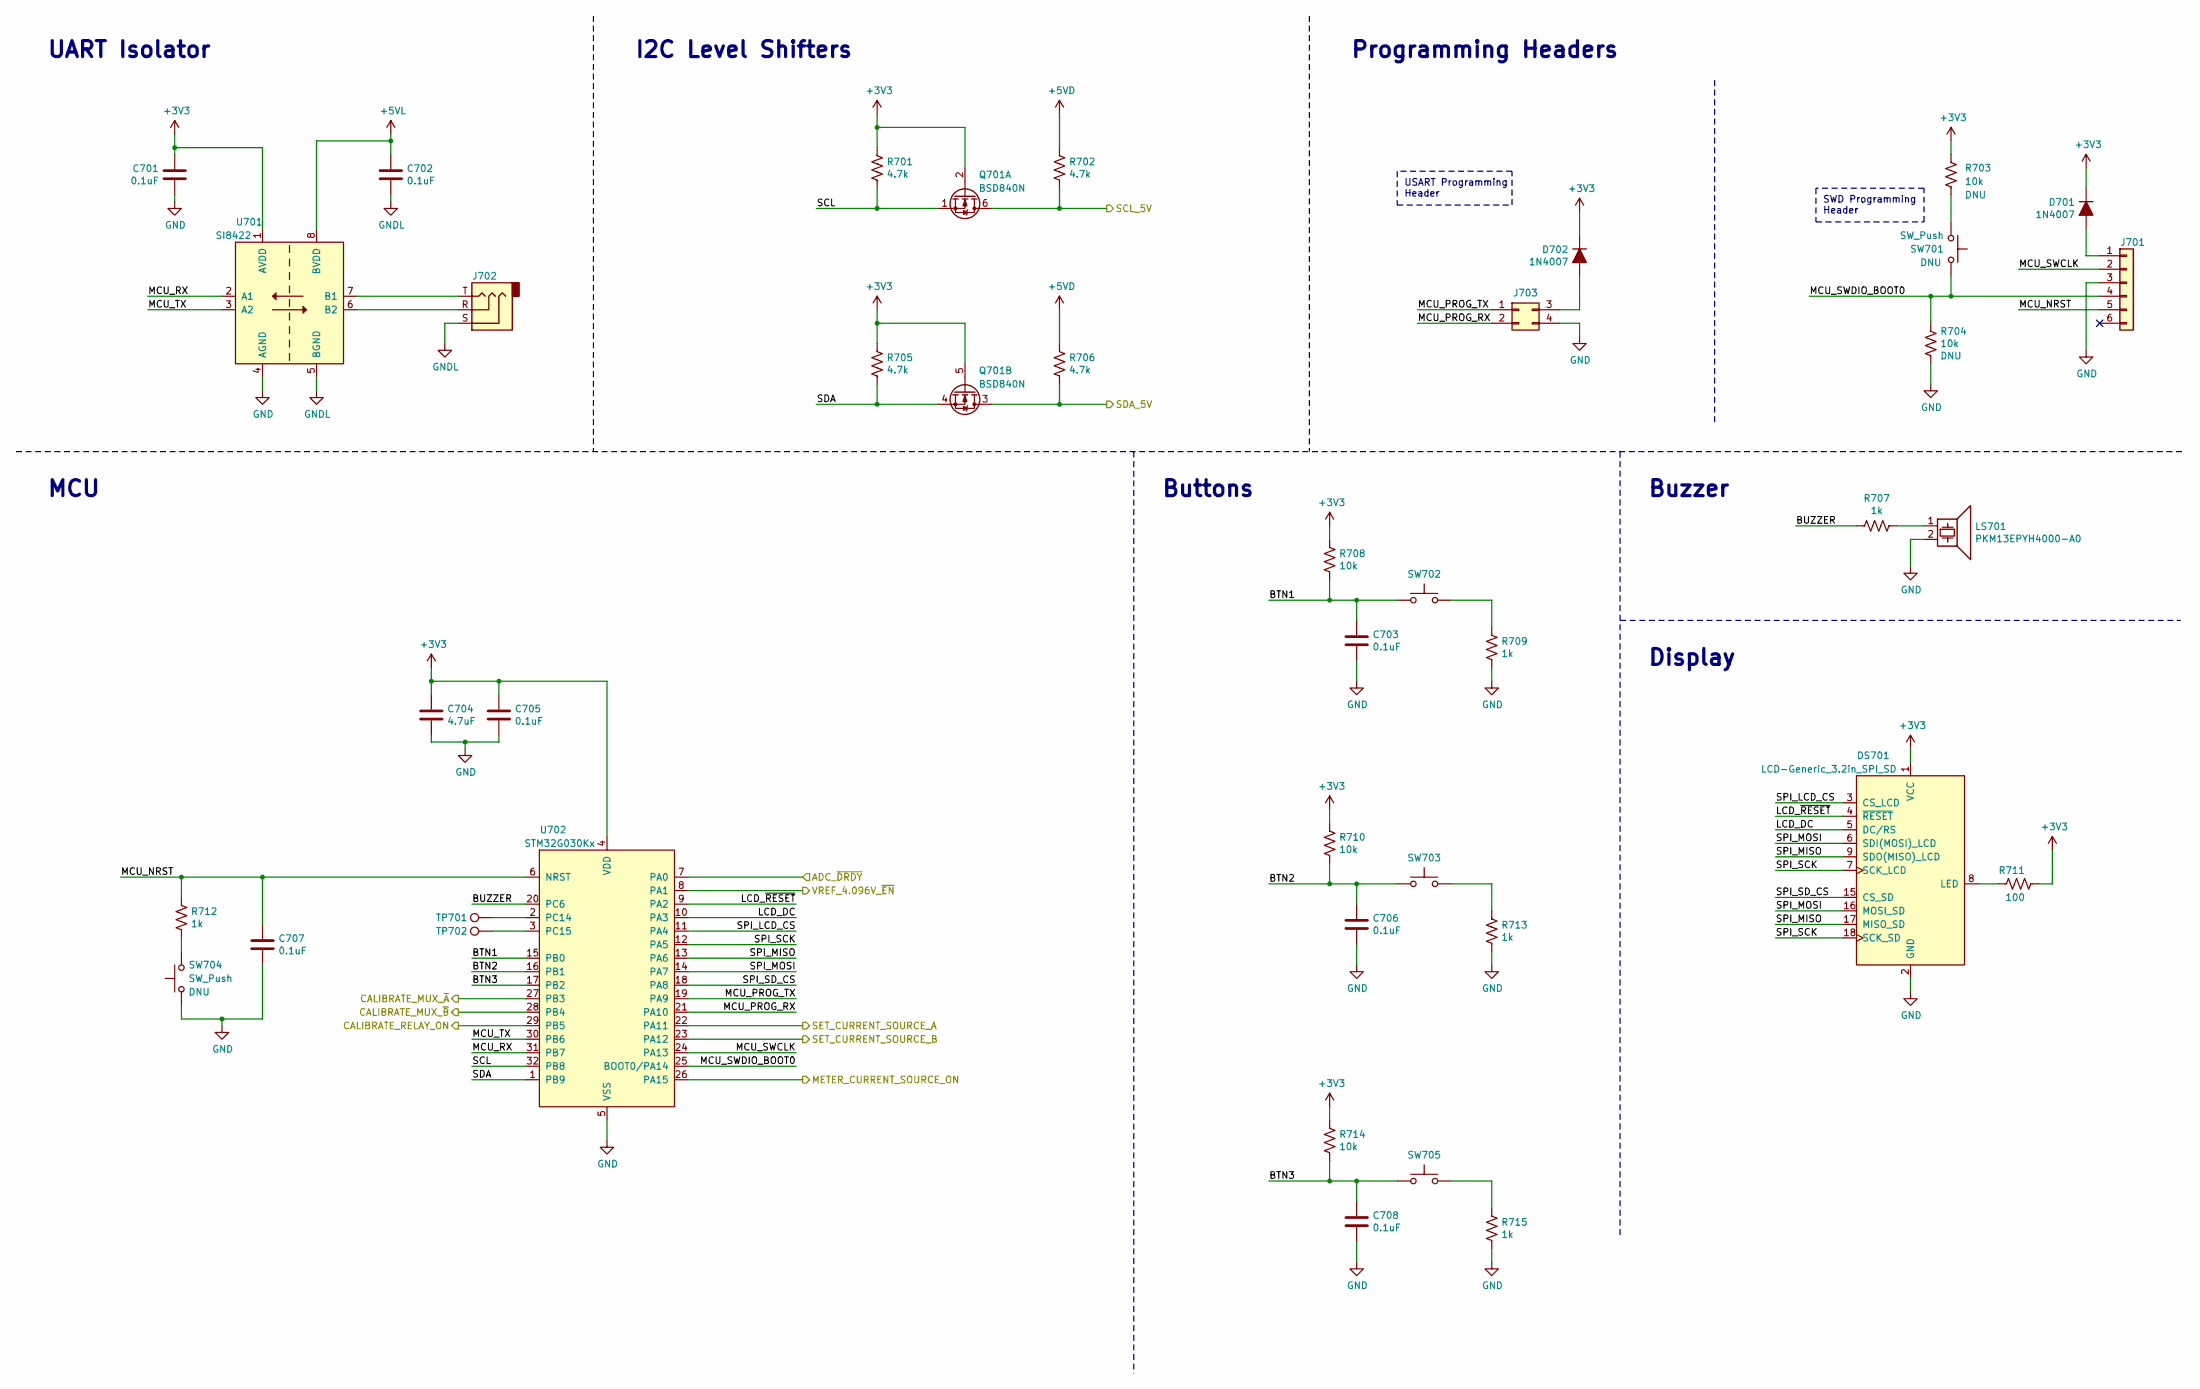
[picture p18: schematic MCU.sch, Toast-O-Meter]

Parts:
C701, C702, C703, C705, C706, C707, C708: 0.1uF; C_0603_1608Metric_Pad1.08x0.95mm_HandSolder; Digi-Key PN 1276-1006-1-ND
C704: 4.7uF; C_0805_2012Metric_Pad1.18x1.45mm_HandSolder; Digi-Key PN 1276-6462-1-ND
D701, D702: 1N4007; D_SOD-123; Digi-Key PN 1655-1N4007FLCT-ND
DS701: LCD-Generic_3.2in_SPI_SD; LCD-Generic-3.2in_89.30x55.04mm_ReducedCourtyard; Digi-Key PN SAM1093-04-ND; SAM1093-14-ND
J701: Conn_01x06; PinHeader_1x06_P2.54mm_Horizontal; Digi-Key PN 2057-PH1RA-06-UA-ND
J702: AudioJack3; Jack_3.5mm_CUI_SJ1-3523N_Horizontal; Digi-Key PN CP1-3523N-ND
J703: Conn_02x02_Top_Bottom; PinHeader_2x02_P2.54mm_Horizontal; Digi-Key PN 2057-PH2RA-04-UA-ND
LS701: PKM13EPYH4000-A0; Buzzer_Murata_PKM13EPYH4000-A0_D12.6mm_H6.9mm; MPN PKM13EPYH4000-A0; Digi-Key PN 490-4698-1-ND
Q701: BSD840N; SOT-363_SC-70-6_Handsoldering; MPN BSD840NH6327XTSA1; Digi-Key PN BSD840NH6327XTSA1CT-ND
R701, R702, R705, R706: 4.7k; R_0603_1608Metric_Pad1.05x0.95mm_HandSolder; Digi-Key PN 311-4.70KHRCT-ND
R703, R704, R708, R710, R714: 10k; R_0603_1608Metric_Pad1.05x0.95mm_HandSolder; Digi-Key PN 311-10.0KHRCT-ND
R707, R709, R712, R713, R715: 1k; R_0603_1608Metric_Pad1.05x0.95mm_HandSolder; Digi-Key PN 311-1.00KHRCT-ND
R711: 100; R_0603_1608Metric_Pad1.05x0.95mm_HandSolder; Digi-Key PN 311-100HRCT-ND
SW701, SW704: SW_Push; SW-PUSH-6x3.5mm_CK-PTS636SL43x_HandSolder; Digi-Key PN CKN12309-1-ND
SW702, SW703, SW705: SW_Push; SW_PUSH-12mm_Wuerth-430476085716_HandSolder; Digi-Key PN 732-13655-1-ND
TP701, TP702: TestPoint; TestPoint_THTPad_D1.5mm_Drill0.7mm; Digi-Key PN 2057-PH2-10-UA-ND
U701: SI8422; SOIC-8_3.9x4.9mm_P1.27mm; Digi-Key PN SI8422AB-D-IS-ND
U702: STM32G030Kx; LQFP-32_7x7mm_P0.8mm; Digi-Key PN 497-19769-ND

Connections:
+3V3: C701.1, C704.1, C705.1, D701.1 (K), D702.1 (K), DS701.1 (VCC), Q701.2 (G1), Q701.5 (G2), R701.1, R703.1, R705.1, R708.1, R710.1, R711.2, R714.1, U701.1 (AVDD), U702.4 (VDD); also elsewhere on the board
+5VD: R702.1, R706.1; also elsewhere on the board
+5VL: C702.1, U701.8 (BVDD); also elsewhere on the board
/ADC/ADC_~DRDY: U702.7 (PA0); also elsewhere on the board
/ADC/SCL_5V: Q701.6 (D1), R702.2; also elsewhere on the board
/ADC/SDA_5V: Q701.3 (D2), R706.2; also elsewhere on the board
/ADC/VREF_4.096V_~EN: U702.8 (PA1); also elsewhere on the board
/Front End/CALIBRATE_MUX_~A: U702.27 (PB3); also elsewhere on the board
/Front End/CALIBRATE_MUX_~B: U702.28 (PB4); also elsewhere on the board
/Front End/CALIBRATE_RELAY_ON: U702.29 (PB5); also elsewhere on the board
/Front End/METER_CURRENT_SOURCE_ON: U702.26 (PA15); also elsewhere on the board
/Front End/SET_CURRENT_SOURCE_A: U702.22 (PA11); also elsewhere on the board
/Front End/SET_CURRENT_SOURCE_B: U702.23 (PA12); also elsewhere on the board
/MCU & Display/BTN1: C703.1, R708.2, SW702.1, U702.15 (PB0)
/MCU & Display/BTN2: C706.1, R710.2, SW703.1, U702.16 (PB1)
/MCU & Display/BTN3: C708.1, R714.2, SW705.1, U702.17 (PB2)
/MCU & Display/BUZZER: R707.1, U702.20 (PC6)
/MCU & Display/LCD_DC: DS701.5 (DC/RS), U702.10 (PA3)
/MCU & Display/LCD_~RESET~: DS701.4 (~RESET), U702.9 (PA2)
/MCU & Display/MCU_NRST: C707.1, J701.5, R712.1, U702.6 (NRST)
/MCU & Display/MCU_PROG_RX: J703.2, U702.21 (PA10)
/MCU & Display/MCU_PROG_TX: J703.1, U702.19 (PA9)
/MCU & Display/MCU_RX: U701.2 (A1), U702.31 (PB7)
/MCU & Display/MCU_SWCLK: J701.2, U702.24 (PA13)
/MCU & Display/MCU_SWDIO_BOOT0: J701.4, R704.1, SW701.2, U702.25 (BOOT0/PA14)
/MCU & Display/MCU_TX: U701.3 (A2), U702.30 (PB6)
/MCU & Display/SCL: Q701.1 (S1), R701.2, U702.32 (PB8)
/MCU & Display/SDA: Q701.4 (S2), R705.2, U702.1 (PB9)
/MCU & Display/SPI_LCD_CS: DS701.3 (CS_LCD), U702.11 (PA4)
/MCU & Display/SPI_MISO: DS701.9 (SDO(MISO)_LCD), DS701.17 (MISO_SD), U702.13 (PA6)
/MCU & Display/SPI_MOSI: DS701.6 (SDI(MOSI)_LCD), DS701.16 (MOSI_SD), U702.14 (PA7)
/MCU & Display/SPI_SCK: DS701.7 (SCK_LCD), DS701.18 (SCK_SD), U702.12 (PA5)
/MCU & Display/SPI_SD_CS: DS701.15 (CS_SD), U702.18 (PA8)
GND: C701.2, C703.2, C704.2, C705.2, C706.2, C707.2, C708.2, DS701.2 (GND), J701.3, J703.4, LS701.2, R704.2, R709.2, R713.2, R715.2, SW704.1, U701.4 (AGND), U702.5 (VSS); also elsewhere on the board
GNDL: C702.2, J702.S, U701.5 (BGND); also elsewhere on the board
unnamed: D701.2 (A), J701.1
unnamed: D702.2 (A), J703.3
unnamed: DS701.8 (LED), R711.1
unnamed: J702.R, U701.6 (B2)
unnamed: J702.T, U701.7 (B1)
unnamed: LS701.1, R707.2
unnamed: R703.2, SW701.1
unnamed: R709.1, SW702.2
unnamed: R712.2, SW704.2
unnamed: R713.1, SW703.2
unnamed: R715.1, SW705.2
unnamed: TP701.1, U702.2 (PC14)
unnamed: TP702.1, U702.3 (PC15)

Notes on the sheet:
USART Programming Header
SWD Programming Header
Programming Headers
MCU
I2C Level Shifters
UART Isolator
Buttons
Display
Buzzer

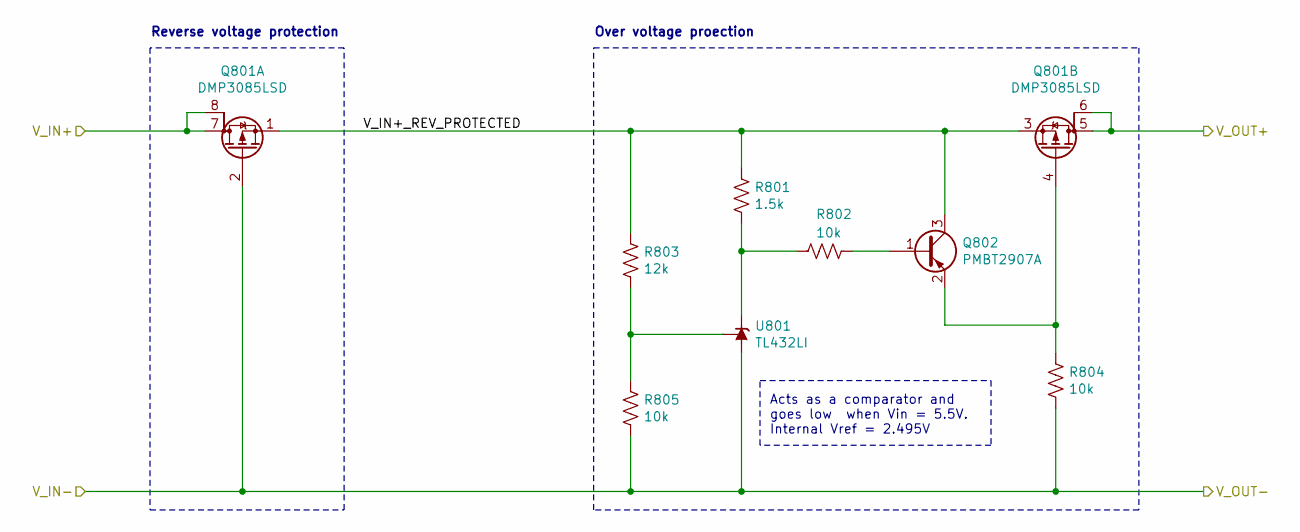
[picture p19: schematic Power_Input_Protection.sch, Toast-O-Meter]

Parts:
Q801: DMP3085LSD; SO-8_3.9x4.9mm_P1.27mm; MPN DMP3085LSD; Digi-Key PN DMP3085LSD-13DICT-ND
Q802: PMBT2907A; SOT-23_Handsoldering; MPN PMBT2907A; Digi-Key PN 1727-2958-1-ND
R801: 1.5k; R_0603_1608Metric_Pad1.05x0.95mm_HandSolder; Digi-Key PN 311-1.50KHRCT-ND
R802, R804, R805: 10k; R_0603_1608Metric_Pad1.05x0.95mm_HandSolder; Digi-Key PN 311-10.0KHRCT-ND
R803: 12k; R_0603_1608Metric_Pad1.05x0.95mm_HandSolder; Digi-Key PN 311-12.0KHRCT-ND
U801: TL432LI; SOT-23; MPN TL432LI; Digi-Key PN 296-53244-1-ND

Connections:
+5VL: Q801.5 (D), Q801.6 (G); also elsewhere on the board
/Power Input Protection/V_IN+: Q801.7 (D), Q801.8 (G); also elsewhere on the board
/Power Input Protection/V_IN+_REV_PROTECTED: Q801.1 (S), Q801.3 (S), Q802.3 (C), R801.2, R803.2
GNDL: Q801.2 (G), R804.1, R805.1, U801.3 (A); also elsewhere on the board
unnamed: Q801.4 (G), Q802.2 (E), R804.2
unnamed: Q802.1 (B), R802.1
unnamed: R801.1, R802.2, U801.1 (K)
unnamed: R803.1, R805.2, U801.2 (REF)

Notes on the sheet:
Reverse voltage protection
Over voltage proection
Acts as a comparator and goes low when Vin = 5.5V. Internal Vref = 2.495V
