Acliad/toast-o-meter/Board Files/Breadboard_DMM/Breadboard_DMM.kicad_pcb

## KiCad design Board Files/Breadboard_DMM/Breadboard_DMM.kicad_pcb (continued)

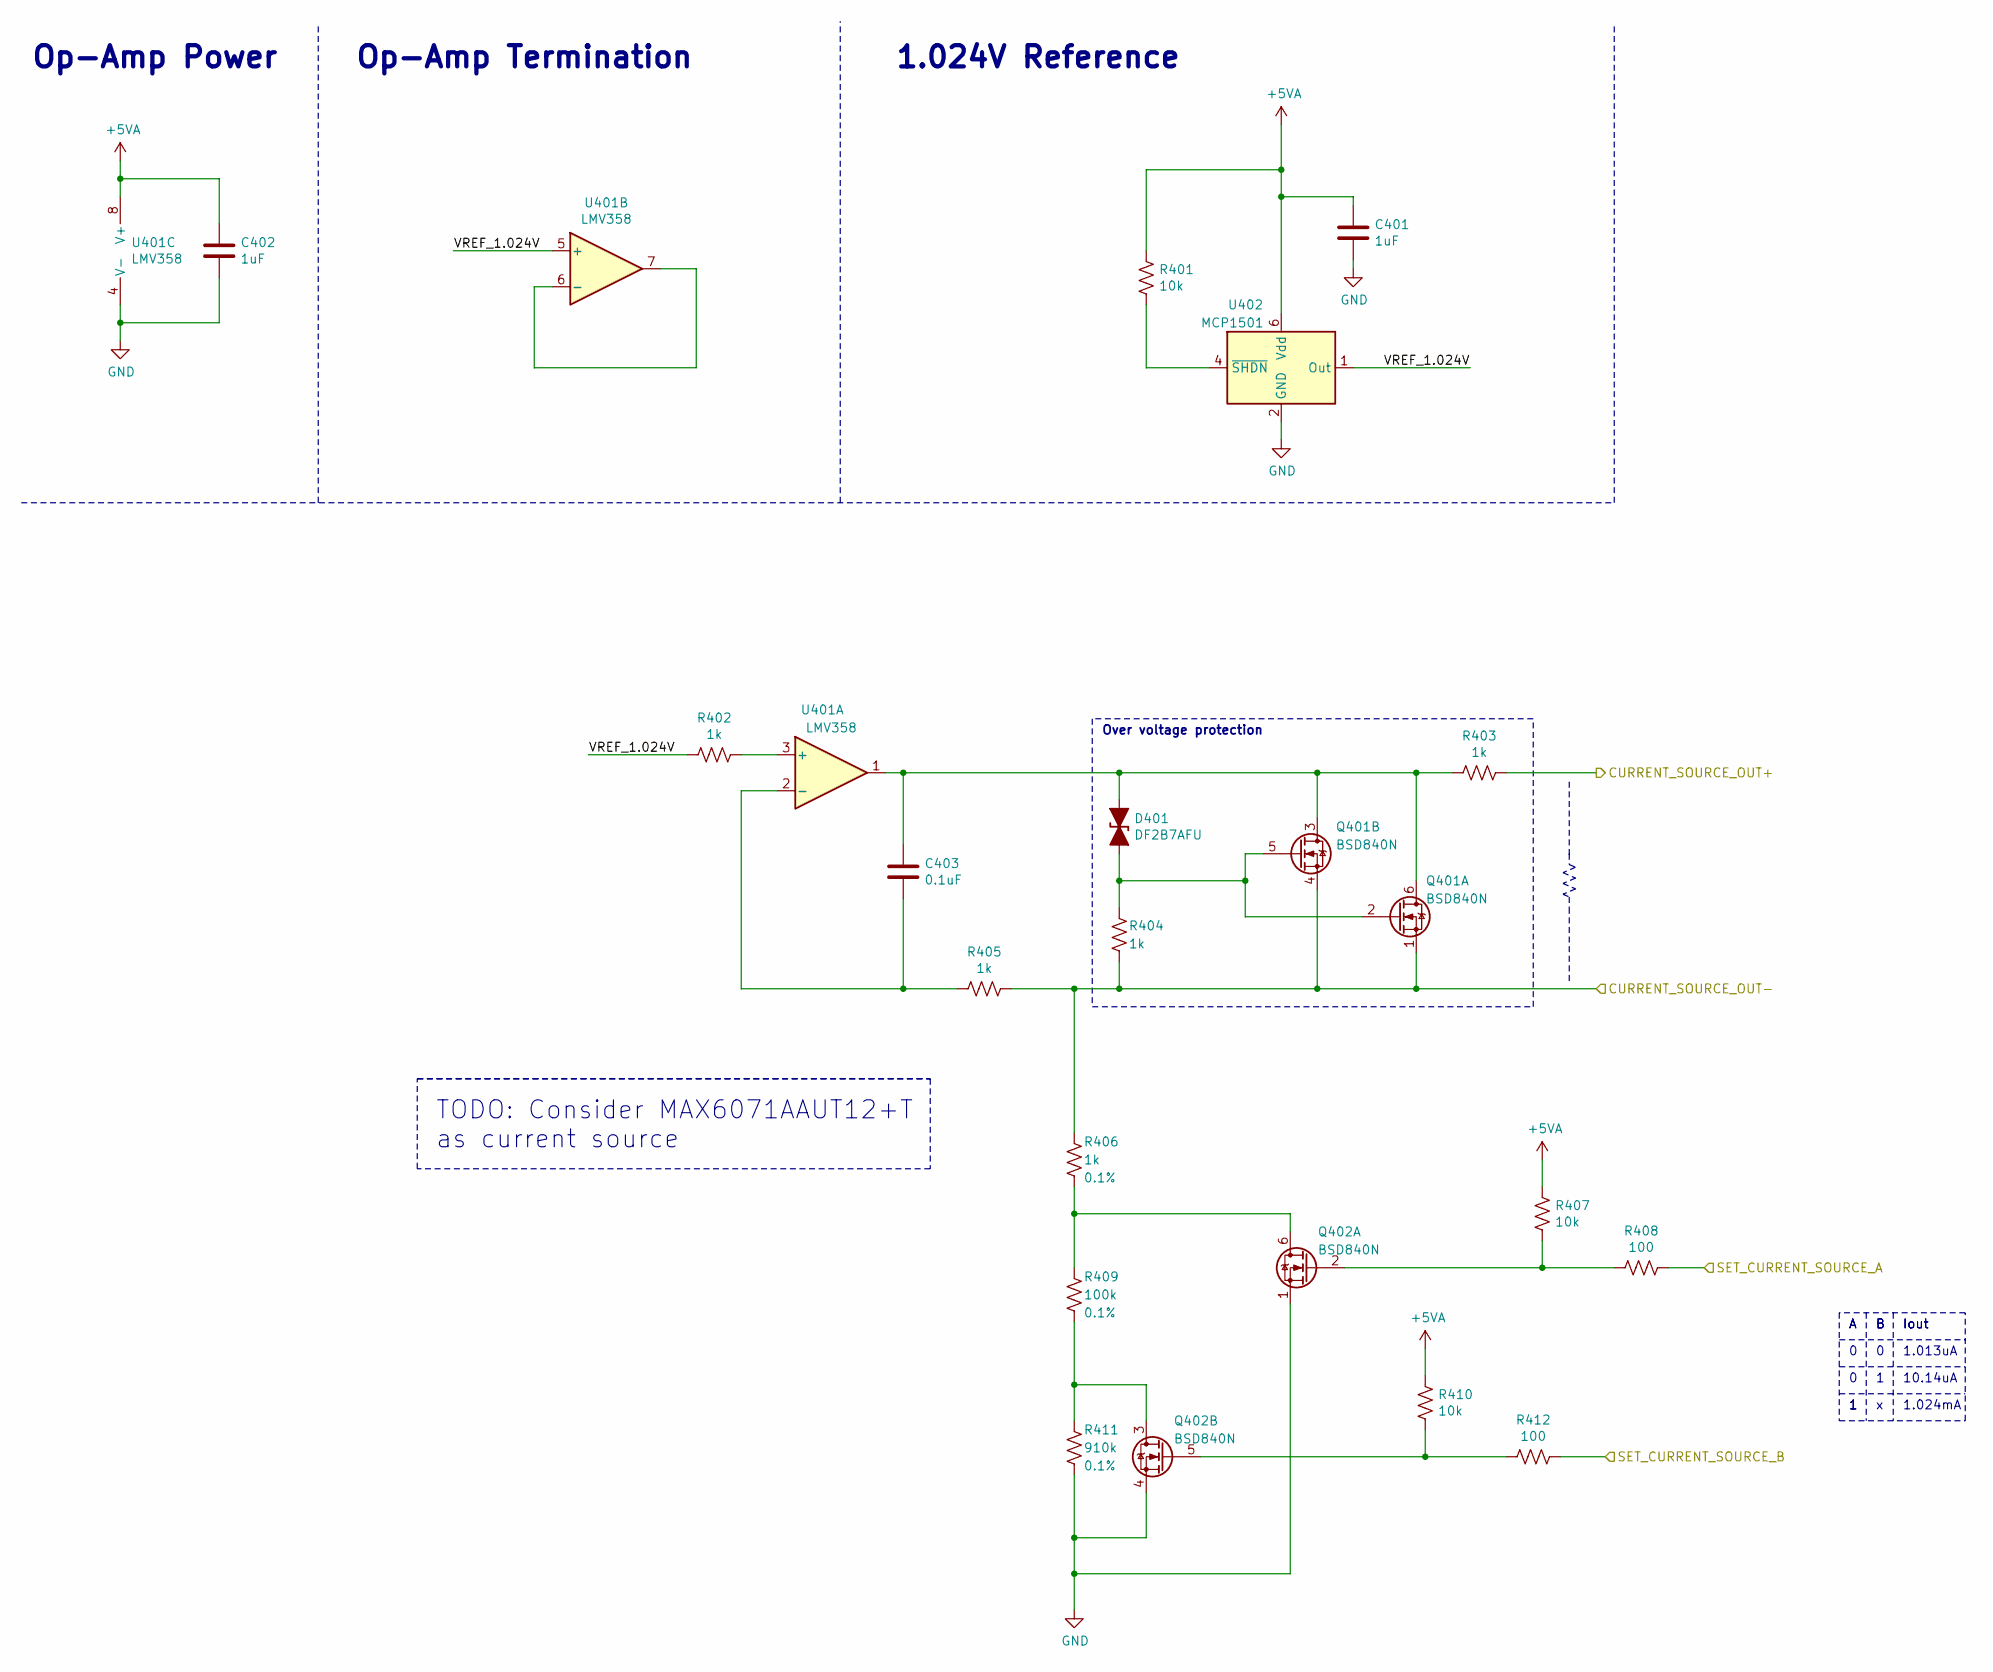
[picture p20: schematic Ohmeter Current Source.sch, Toast-O-Meter]

Parts:
C401, C402: 1uF; C_0603_1608Metric_Pad1.08x0.95mm_HandSolder; Digi-Key PN 1276-6524-1-ND
C403: 0.1uF; C_0603_1608Metric_Pad1.08x0.95mm_HandSolder; Digi-Key PN 1276-1006-1-ND
D401: DF2B7AFU; D_SOD-323_HandSoldering; MPN DF2B7AFU; Digi-Key PN DF2B7AFUH3FCT-ND
Q401, Q402: BSD840N; SOT-363_SC-70-6_Handsoldering; MPN BSD840NH6327XTSA1; Digi-Key PN BSD840NH6327XTSA1CT-ND
R401, R407, R410: 10k; R_0603_1608Metric_Pad1.05x0.95mm_HandSolder; Digi-Key PN 311-10.0KHRCT-ND
R402, R403, R404, R405: 1k; R_0603_1608Metric_Pad1.05x0.95mm_HandSolder; Digi-Key PN 311-1.00KHRCT-ND
R406: 1k; R_0805_2012Metric_Pad1.15x1.40mm_HandSolder; Tolerance 0.1%; Digi-Key PN YAG1820CT-ND
R408, R412: 100; R_0603_1608Metric_Pad1.05x0.95mm_HandSolder; Digi-Key PN 311-100HRCT-ND
R409: 100k; R_0805_2012Metric_Pad1.15x1.40mm_HandSolder; Tolerance 0.1%; Digi-Key PN YAG1759CT-ND
R411: 910k; R_0805_2012Metric_Pad1.15x1.40mm_HandSolder; Tolerance 0.1%; Digi-Key PN YAG1993CT-ND
U401: LMV358; SOIC-8_3.9x4.9mm_P1.27mm; Digi-Key PN 296-47593-1-ND
U402: MCP1501; SOT-23-6; Digi-Key PN MCP1501T-10E/CHYCT-ND

Connections:
+5VA: C401.1, C402.1, R401.1, R407.1, R410.1, U401.8 (V+), U402.6 (Vdd); also elsewhere on the board
/Front End/CURRENT_SOURCE_-: Q401.1 (S1), Q401.4 (S2), R404.1, R405.1, R406.1; also elsewhere on the board
/Front End/Ohmeter Current Source/CURRENT_SOURCE_OUT+: R403.1; also elsewhere on the board
/Front End/Ohmeter Current Source/VREF_1.024V: R402.2, U401.5 (+), U402.1 (Out)
/Front End/SET_CURRENT_SOURCE_A: R408.2; also elsewhere on the board
/Front End/SET_CURRENT_SOURCE_B: R412.2; also elsewhere on the board
GND: C401.2, C402.2, Q402.1 (S1), Q402.4 (S2), R411.2, U401.4 (V-), U402.2 (GND), U402.3 (GND), U402.5 (GND); also elsewhere on the board
unnamed: C403.1, D401.1 (A1), Q401.3 (D2), Q401.6 (D1), R403.2, U401.1
unnamed: C403.2, R405.2, U401.2 (-)
unnamed: D401.2 (A2), Q401.2 (G1), Q401.5 (G2), R404.2
unnamed: Q402.2 (G1), R407.2, R408.1
unnamed: Q402.3 (D2), R409.2, R411.1
unnamed: Q402.5 (G2), R410.2, R412.1
unnamed: Q402.6 (D1), R406.2, R409.1
unnamed: R401.2, U402.4 (~SHDN~)
unnamed: R402.1, U401.3 (+)
unnamed: U401.6 (-), U401.7

Notes on the sheet:
Op-Amp Power
1.024V Reference
Op-Amp Termination
Iout
1.013uA
10.14uA
1.024mA
Over voltage protection
TODO: Consider MAX6071AAUT12+T as current source

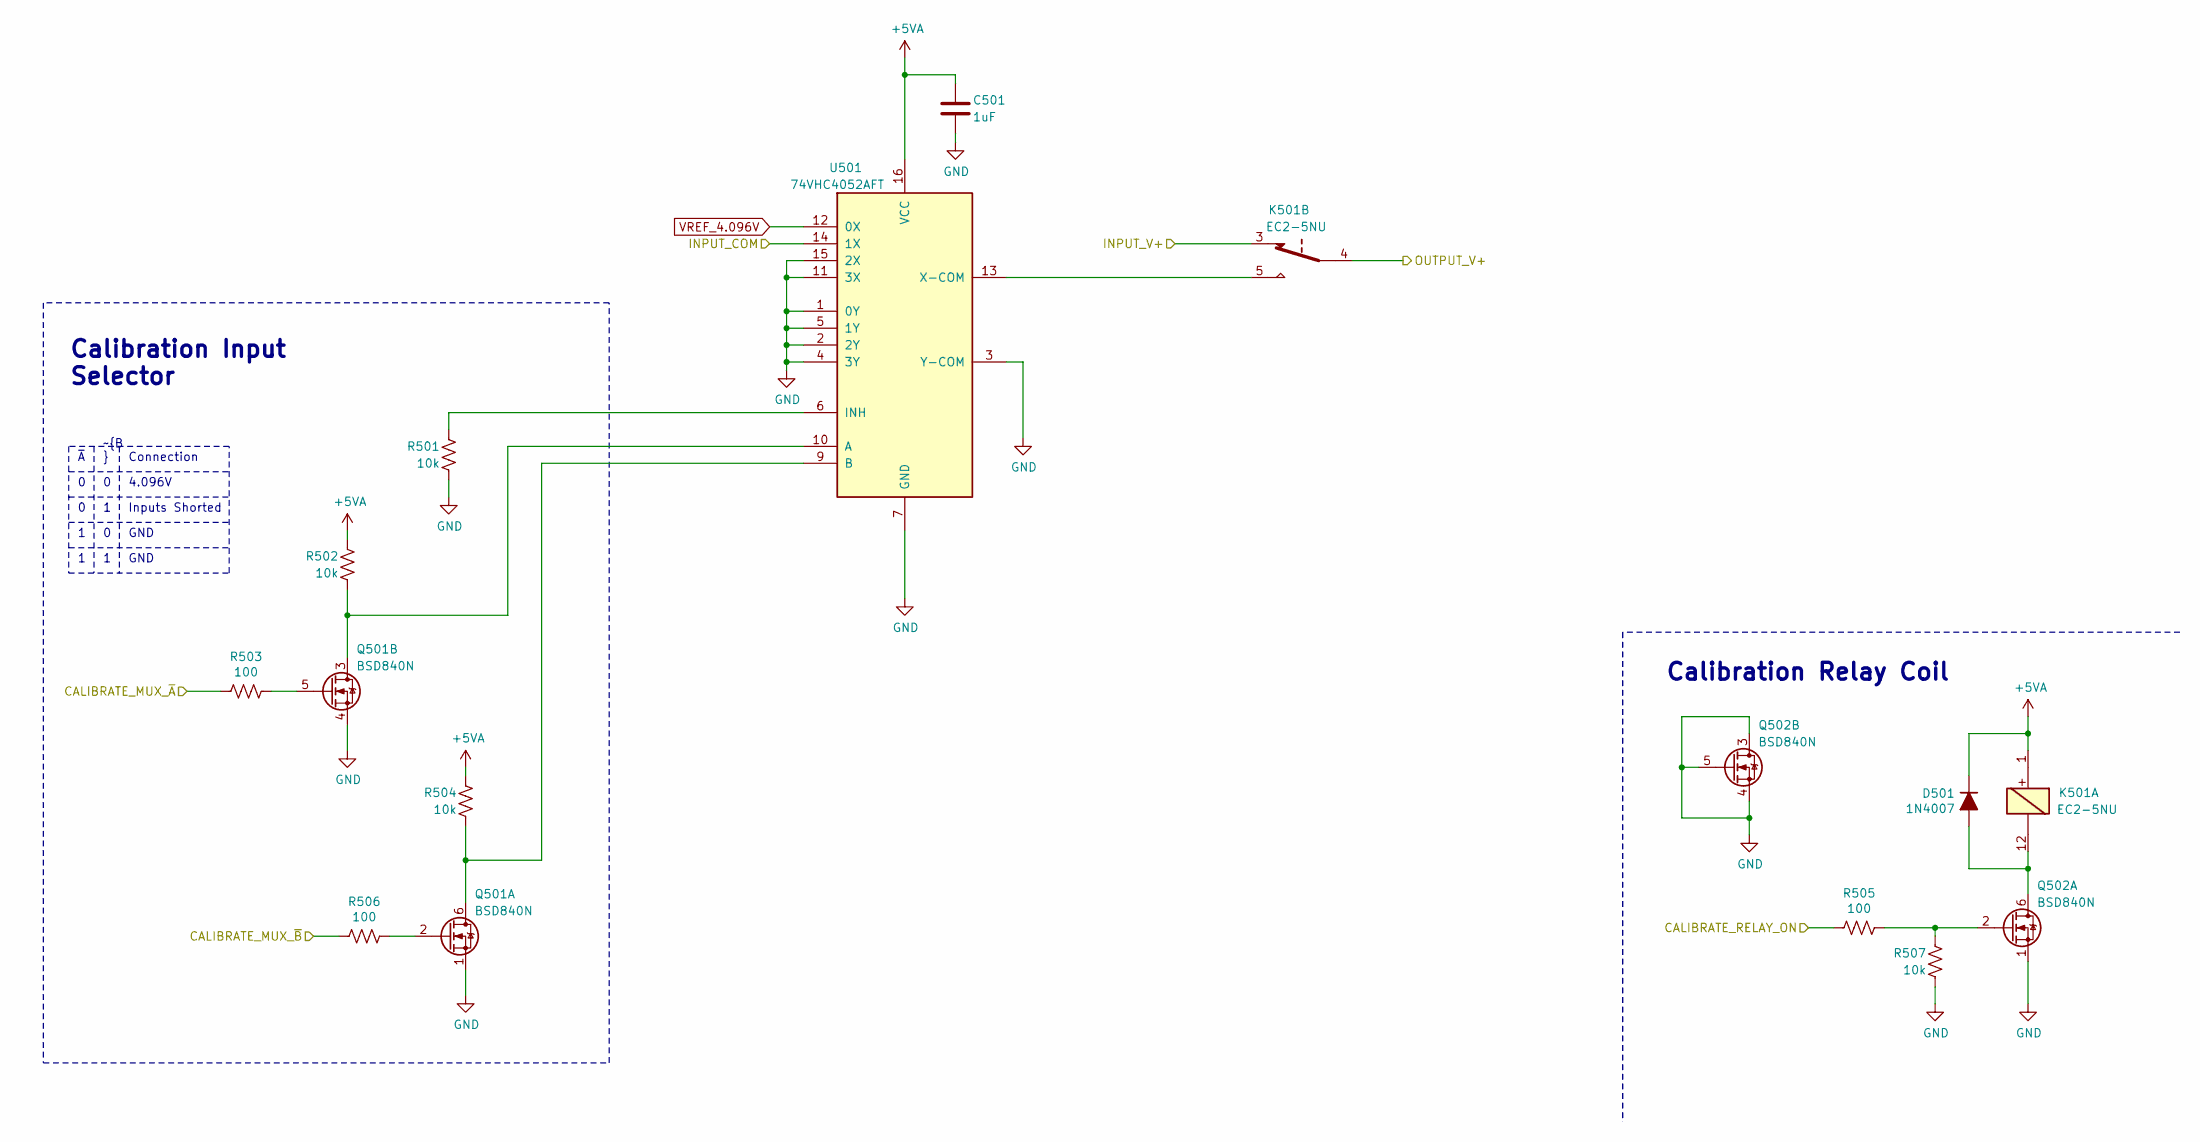
[picture p21: schematic Calibration Mux.sch, Toast-O-Meter]

Parts:
C501: 1uF; C_0603_1608Metric_Pad1.08x0.95mm_HandSolder; Digi-Key PN 1276-6524-1-ND
D501: 1N4007; D_SOD-123; Digi-Key PN 1655-1N4007FLCT-ND
K501: EC2-5NU; Relay_DPDT_Kemet_EC2; MPN EC2-5NU; Digi-Key PN 399-11052-5-ND
Q501, Q502: BSD840N; SOT-363_SC-70-6_Handsoldering; MPN BSD840NH6327XTSA1; Digi-Key PN BSD840NH6327XTSA1CT-ND
R501, R502, R504, R507: 10k; R_0603_1608Metric_Pad1.05x0.95mm_HandSolder; Digi-Key PN 311-10.0KHRCT-ND
R503, R505, R506: 100; R_0603_1608Metric_Pad1.05x0.95mm_HandSolder; Digi-Key PN 311-100HRCT-ND
U501: 74VHC4052AFT; TSSOP-16_4.4x5mm_P0.65mm; Digi-Key PN 74VHC4052AFTCT-ND

Connections:
+5VA: C501.1, D501.1 (K), K501.1, R502.1, R504.1, U501.16 (VCC); also elsewhere on the board
/ADC/V-_INPUT: U501.14 (1X); also elsewhere on the board
/Front End/CALIBRATE_MUX_~A: R503.1; also elsewhere on the board
/Front End/CALIBRATE_MUX_~B: R506.1; also elsewhere on the board
/Front End/CALIBRATE_RELAY_ON: R505.1; also elsewhere on the board
/Front End/Calibration Mux/OUTPUT_V+: K501.4; also elsewhere on the board
/Front End/V+: K501.3; also elsewhere on the board
GND: C501.2, Q501.1 (S1), Q501.4 (S2), Q502.1 (S1), Q502.3 (D2), Q502.4 (S2), Q502.5 (G2), R501.2, R507.2, U501.1 (0Y), U501.2 (2Y), U501.3 (Y-COM), U501.4 (3Y), U501.5 (1Y), U501.7 (GND), U501.8 (GND), U501.11 (3X), U501.15 (2X); also elsewhere on the board
unnamed: D501.2 (A), K501.12, Q502.6 (D1)
unnamed: K501.5, U501.13 (X-COM)
unnamed: Q501.2 (G1), R506.2
unnamed: Q501.3 (D2), R502.2, U501.10 (A)
unnamed: Q501.5 (G2), R503.2
unnamed: Q501.6 (D1), R504.2, U501.9 (B)
unnamed: Q502.2 (G1), R505.2, R507.1
unnamed: R501.1, U501.6 (INH)
VREF_4.096V: U501.12 (0X); also elsewhere on the board

Notes on the sheet:
GND
Calibration Relay Coil
Calibration Input Selector
Inputs Shorted
4.096V
Connection

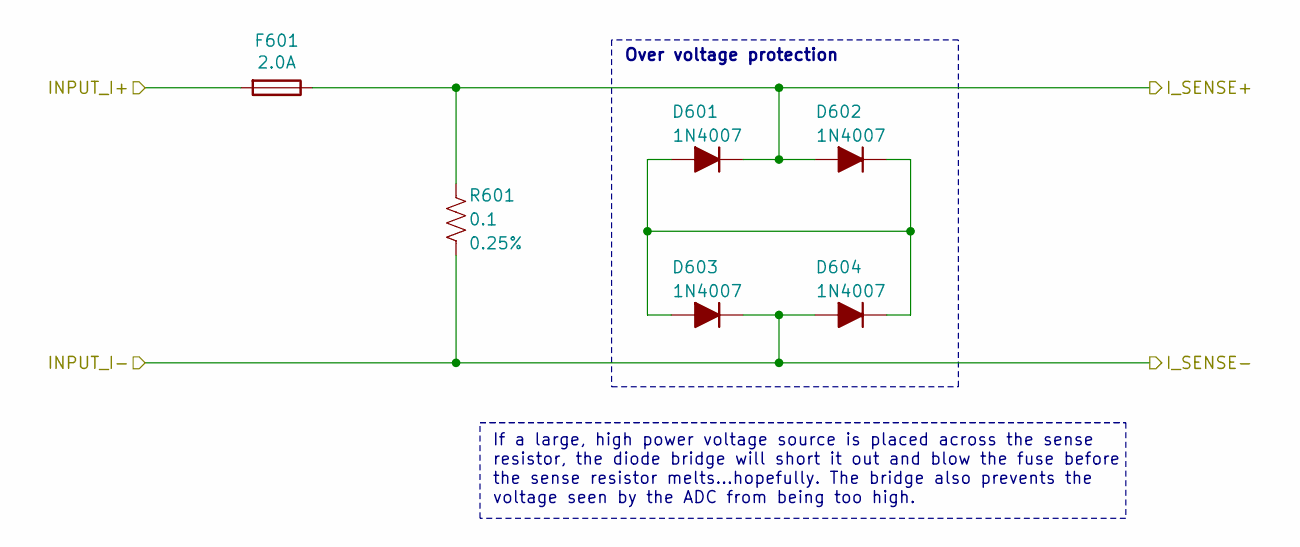
[picture p22: schematic Ammeter_Frontend.sch, Toast-O-Meter]

Parts:
D601, D602, D603, D604: 1N4007; D_SOD-123; Digi-Key PN 1655-1N4007FLCT-ND
F601: 2.0A; Fuseholder_Littelfuse_Nano2_154x; Digi-Key PN F1224TR-ND
R601: 0.1; R_Shunt_Ohmite_LVK24; Tolerance 0.25%; Digi-Key PN 273-LVK24R100CERDKR-ND

Connections:
/ADC/I_SENSE+: D601.1 (K), D602.2 (A), F601.1, R601.1; also elsewhere on the board
/ADC/I_SENSE-: D603.1 (K), D604.2 (A), R601.2; also elsewhere on the board
/Front End/I+: F601.2; also elsewhere on the board
unnamed: D601.2 (A), D602.1 (K), D603.2 (A), D604.1 (K)

Notes on the sheet:
Over voltage protection
If a large, high power voltage source is placed across the sense resistor, the diode bridge will short it out and blow the fuse before the sense resistor melts…hopefully. The bridge also prevents the voltage seen by the ADC from being too high.

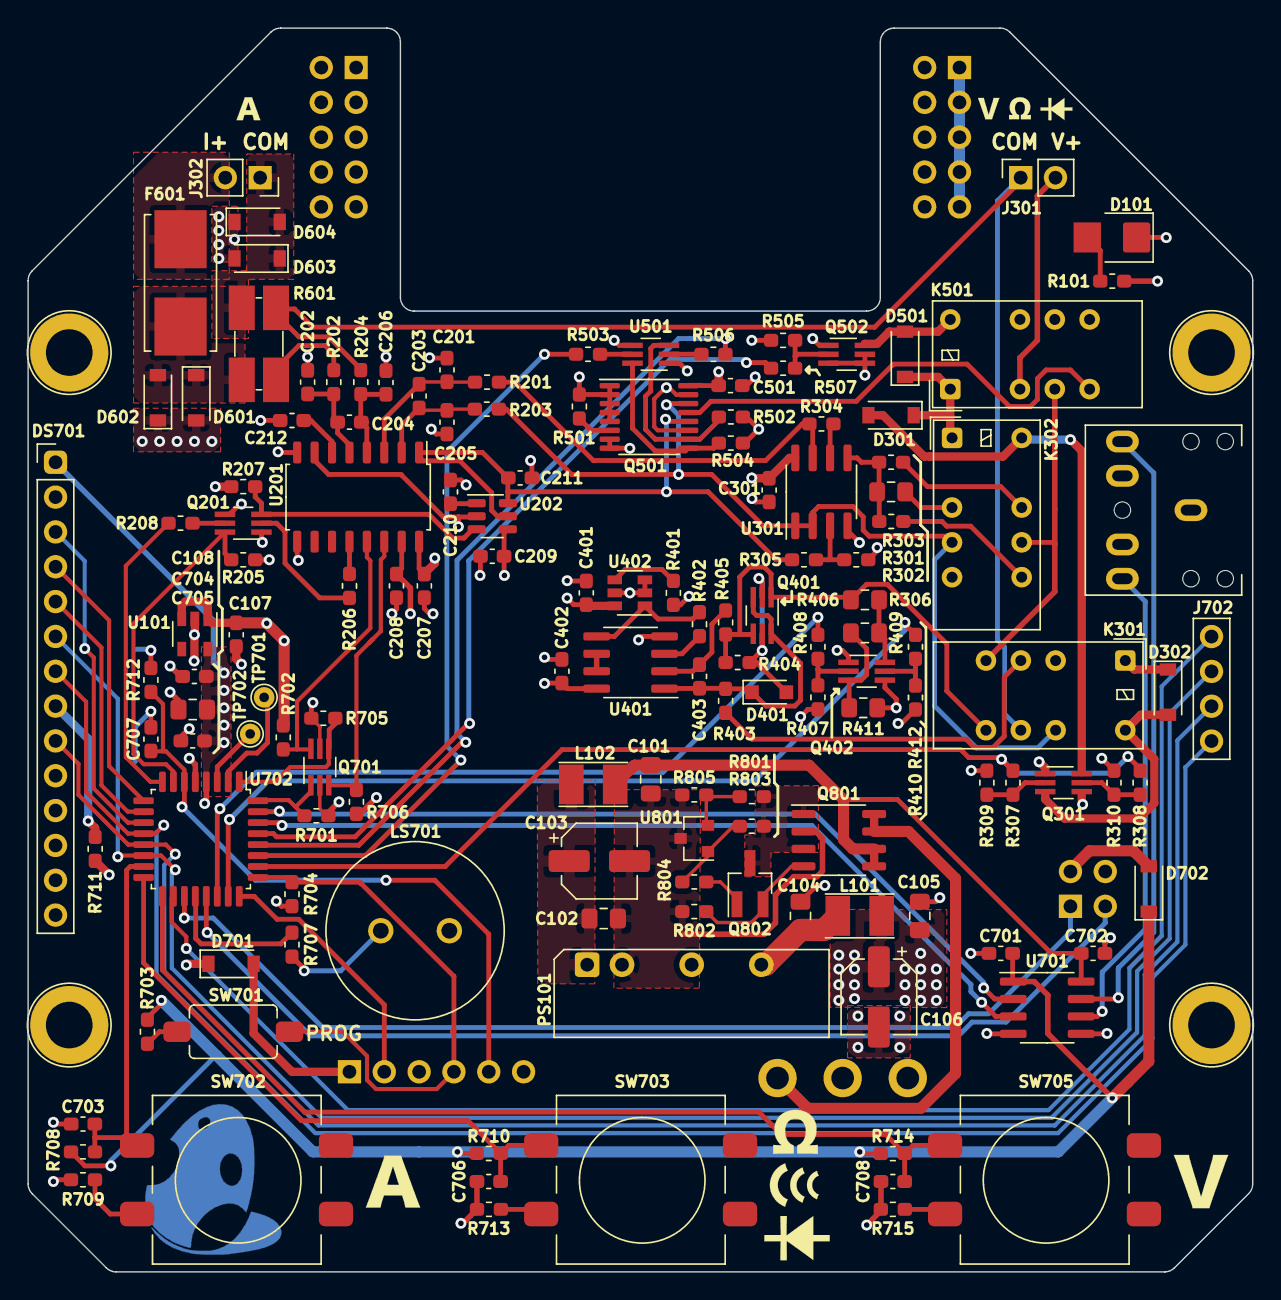
[picture p23: board Breadboard_DMM.kicad_pcb from above]

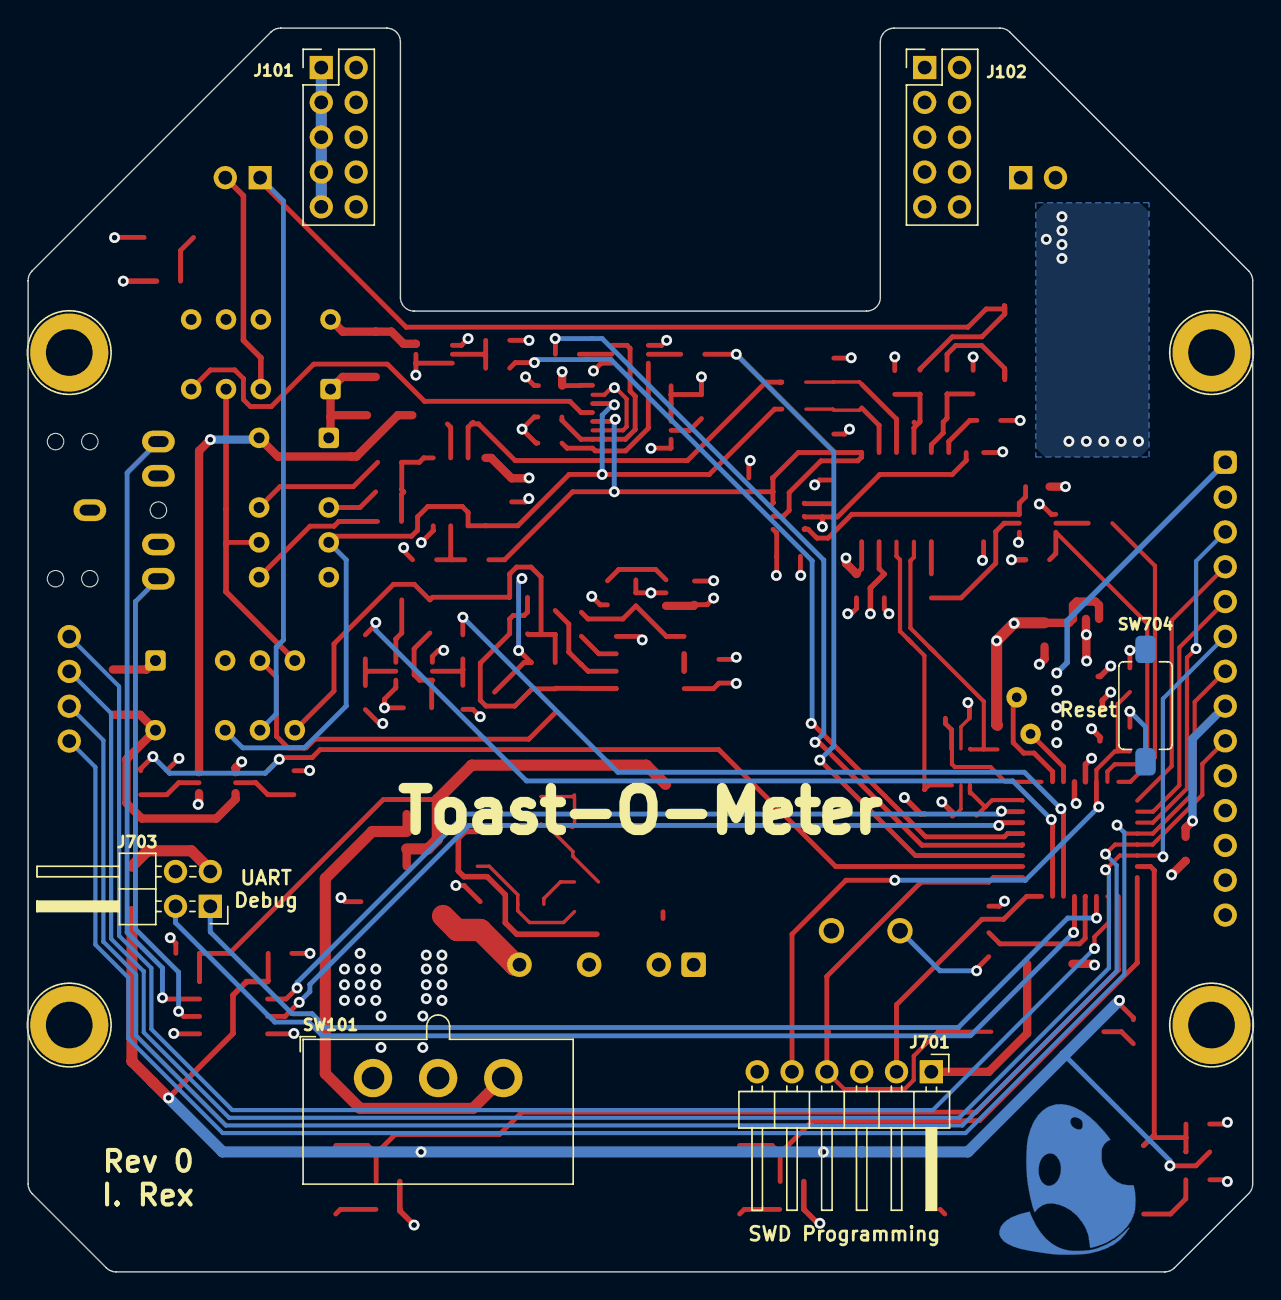
[picture p24: board Breadboard_DMM.kicad_pcb from below]

Board: 4 copper layers, 89.3 x 90.7 mm, 146 parts (6 on the bottom side), 108 nets.
