Acliad/toast-o-meter/Software/NAU7802 Driver/Core/Src/main.c

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
/* Includes ------------------------------------------------------------------*/
#include "main.h"
#include "gpio.h"
#include "i2c.h"
#include "usart.h"


/* USER CODE BEGIN Includes */
#include "nau7802.h"
#include <stdio.h>
#include <string.h>

/* USER CODE END Includes */


void SystemClock_Config(void);
/* USER CODE BEGIN PFP */
void print(char *out_buff);
/* USER CODE END PFP */

/**
 * @brief  The application entry point.
 * @retval int
 */
int main(void) {
    /* USER CODE BEGIN 1 */
    nau7802_t *adc;

    /* USER CODE END 1 */

    /* MCU Configuration--------------------------------------------------------*/

    /* Reset of all peripherals, Initializes the Flash interface and the Systick. */
    HAL_Init();

    /* Configure the system clock */
    SystemClock_Config();

    /* Initialize all configured peripherals */
    MX_GPIO_Init();
    MX_I2C1_Init();
    MX_USART2_UART_Init();
    /* USER CODE BEGIN 2 */
    adc = nau7802_init(&hi2c1);
    nau7802_powerup_sequence(adc);

    /* USER CODE END 2 */

    /* Infinite loop */
    /* USER CODE BEGIN WHILE */
    uint8_t           pu_reg_state = 0;
    HAL_StatusTypeDef status;
    char              buff[50];
    while (1) {
        /* USER CODE END WHILE */
        status = nau7802_reg_read(adc, NAU7802_REG_PUCTRL, &pu_reg_state);
        nau7802_conversion_read(adc);
        sprintf(buff, "PUCTRL: 0x%x\tStatus: %d\nRaw Reading: %ld\n", pu_reg_state, status, adc->conversion);
        print(buff);

        HAL_Delay(500);
        /* USER CODE BEGIN 3 */
    }
    /* USER CODE END 3 */
}

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
/* USER CODE BEGIN 4 */
void print(char *out_buff) { HAL_UART_Transmit(&huart2, (uint8_t *)out_buff, strlen(out_buff), 0xFFFF); }
/* USER CODE END 4 */
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
