Acliad/toast-o-meter/(commit log)

2020-08-21 Started cleaning up front end page
    [ADC.sch, Breadboard_DMM.sch, Calibration Mux.sch, Front End.sch, MCU.sch, Ohmeter Current Source.sch]
2020-08-27 Starting converting to hierachichal design
    [ADC.sch, Breadboard_DMM.sch, Front End.sch, MCU.sch, Ohmeter Current Source.sch]
2020-08-30 Added new sheet for main supply measurement, added upgrades document
    [Breadboard_DMM.sch, Front End.sch, MCU.sch, Ohmeter Current Source.sch, Supply Rail Front End.sch]
2020-09-26 Finished main design, cleaning up schematic
    [ADC.sch, Breadboard_DMM.sch, Calibration Mux.sch, Front End.sch, Level Shifter A.sch, Level Shifter B.sch, MCU.sch, Ohmeter Current Source.sch]
2020-10-02 Finished main cleanup, started adding digikey part numbers
    [ADC.sch, Ammeter_Frontend.sch, Breadboard_DMM.sch, Calibration Mux.sch, Front End.sch, Level Shifter A.sch, Level Shifter B.sch, Level Shifter.sch]
2020-10-03 Started adding Digikey links
    [ADC.sch, Ammeter_Frontend.sch, Breadboard_DMM.sch, Calibration Mux.sch, Front End.sch, Level Shifter.sch, MCU.sch, Ohmeter Current Source.sch]
2020-10-06 Finished adding parts, cleaned up, ran ERC
    [ADC.sch, Ammeter_Frontend.sch, Breadboard_DMM.sch, Calibration Mux.sch, Front End.sch, Level Shifter.sch, MCU.sch, Ohmeter Current Source.sch]
2020-10-06 Cleaned up files
    [Ammeter Current Source.sch, Ammeter_Frontend.sch, Breadboard_DMM.sch, Front End.sch, Power_Input_Protection.sch, user_input.sch]
2020-10-21 Updated probe connector arrangement
    [ADC.sch, Ammeter_Frontend.sch, Breadboard_DMM.sch, Calibration Mux.sch, Front End.sch, MCU.sch, Ohmeter Current Source.sch, Power_Input_Protection.sch]
2020-11-14 Semi-finished component placement
    [ADC.sch, Ammeter_Frontend.sch, Breadboard_DMM.kicad_pcb, Breadboard_DMM.sch, Breadboard_DMM_bom_0.csv, Calibration Mux.sch, Front End.sch, MCU.sch]
2020-11-15 59 unrouted nodes
    [Breadboard_DMM.kicad_pcb, MCU.sch]
2020-11-21 Added silkscreen graphics and BOM
    [Breadboard_DMM-B_Cu.gbr, Breadboard_DMM-B_Mask.gbr, Breadboard_DMM-B_Paste.gbr, Breadboard_DMM-B_SilkS.gbr, Breadboard_DMM-Edge_Cuts.gbr, Breadboard_DMM-F_Cu.gbr, Breadboard_DMM-F_Mask.gbr, Breadboard_DMM-F_Paste.gbr]
2021-01-10 Updated Digikey link for power isolator, started ADC driver
    [Breadboard_DMM.kicad_pcb, Breadboard_DMM.sch]
2021-01-11 Outlined function prototypes
2021-01-16 Finished ADC driver writing functions, almost done with read functions
2021-01-17 Fixed some compiler warnings
    [main.c, nau7802.c, nau7802.h]
2021-01-19 Updated U801 DK link and part number, updated change log
    [ADC.sch, Power_Input_Protection.sch]
